MJ2021/PCR-Machine-Construction/Report_3/EE344-EDL REPORT/Images/Schematic2png.png

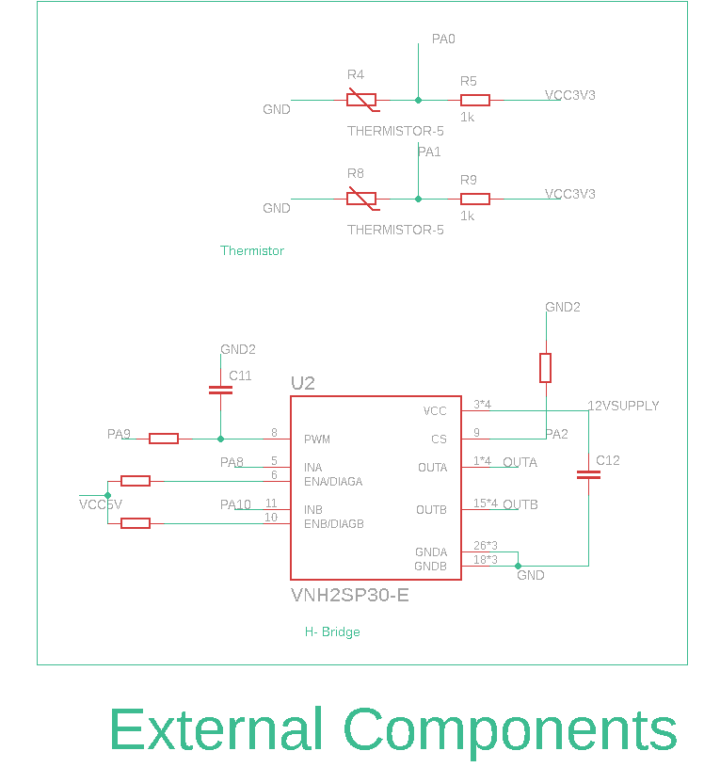
Report_3/EE344-EDL REPORT/Images/Schematic2png.png
