MJ2021/PCR-Machine-Construction/PCR_CAD/Misc/New hinged lid (original).SLDASM

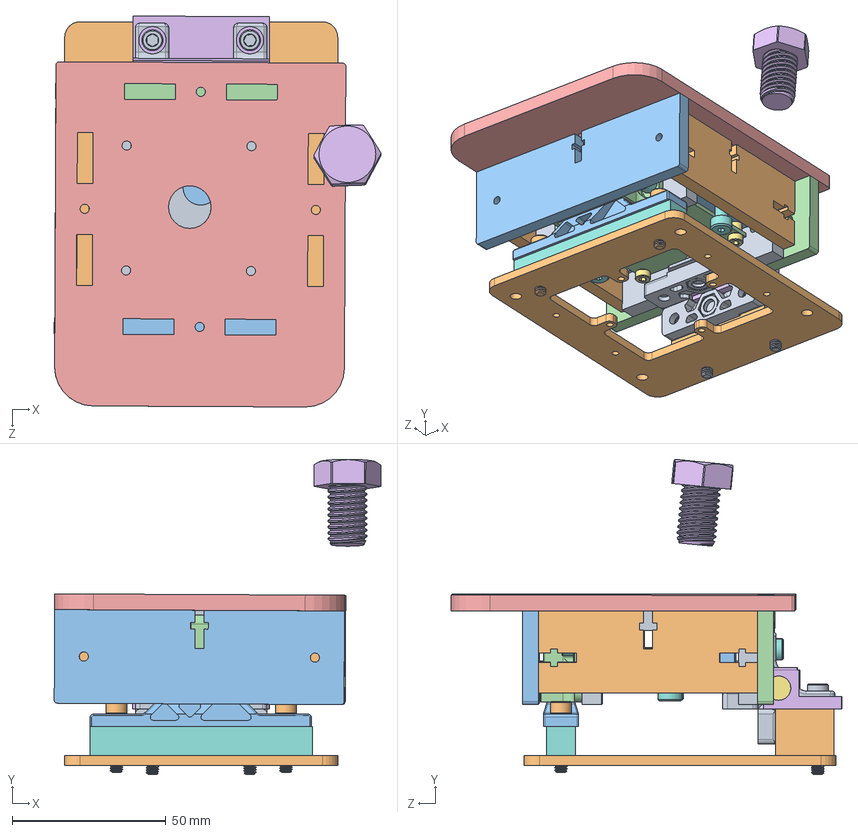
[picture p28: CAD file, 2024-03-14]
PCR_CAD/Misc/New hinged lid (original).SLDASM
106.3 x 102.7 x 127.3 mm
Hinge
Hinge bracket
Heated bracket
Plate
3-4 in bolt
compresed spring 9657K81
1-8 in spacer x 3
Latch bracket
Lid bracket
Mounting plate
SW3dPS-C3-810_c3_keeper_clf
SW3dPS-C3-810_c3_housing_clf
SW3dPS-C3-810_C3_Pawl_Clf
SW3dPS-C3-810_c3_rivet_clf
M3_8mm_SS_screw_91292A112 x 4
3-4in-shoulder screw 3-16 dia x 2
Kapton Heater
Lid_side x 2
Lid_front
Lid_back
Lid_top
Hinge2 x 2
Rod1
5-16in-8-32-hex-screw92196A191 x 6
1in-8-32-hex-92196A199 x 2
3-4in-8-32-hex-92196A197 x 2
