MJ2021/PCR-Machine-Construction/PCR_CAD/Misc/Practice hinge/Hinge1.SLDASM

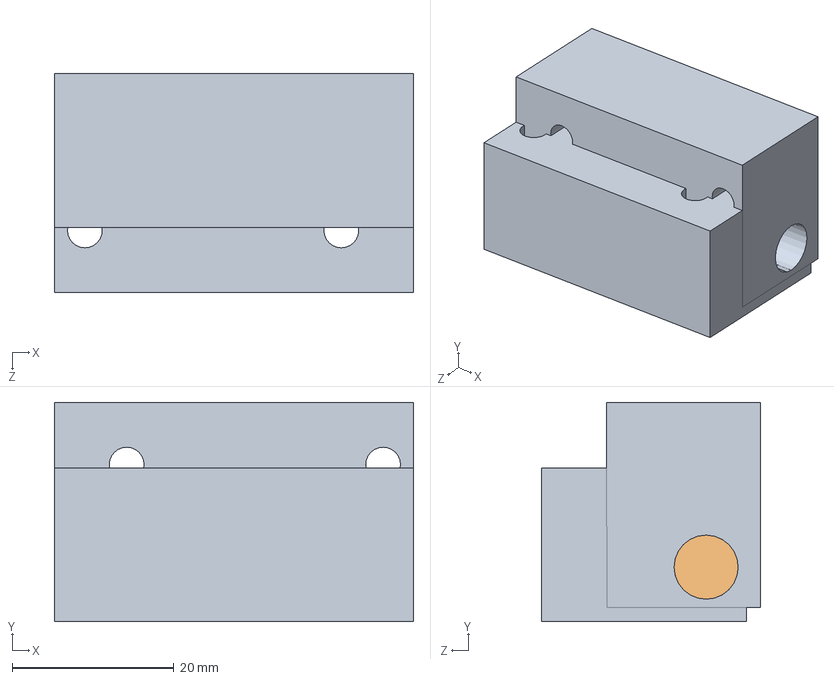
[picture p29: CAD file, 2024-03-14]
PCR_CAD/Misc/Practice hinge/Hinge1.SLDASM
44.5 x 27.1 x 27.1 mm
Hinge2 x 2
Rod1
