MJ2021/PCR-Machine-Construction/PCR_CAD/Heating/Main Heating Block.SLDPRT

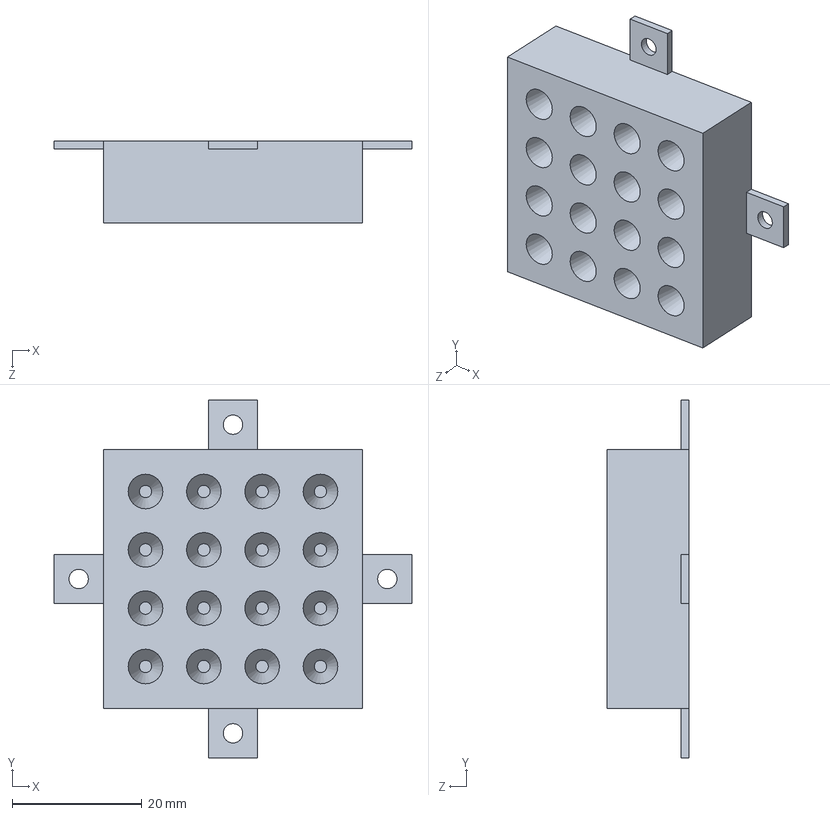
[picture p30: CAD file, 2024-03-14]
PCR_CAD/Heating/Main Heating Block.SLDPRT
55.2 x 55.2 x 12.7 mm
