MJ2021/PCR-Machine-Construction/PCR_CAD/Misc/CK tools prototype A/CK tools prototype.SLDASM

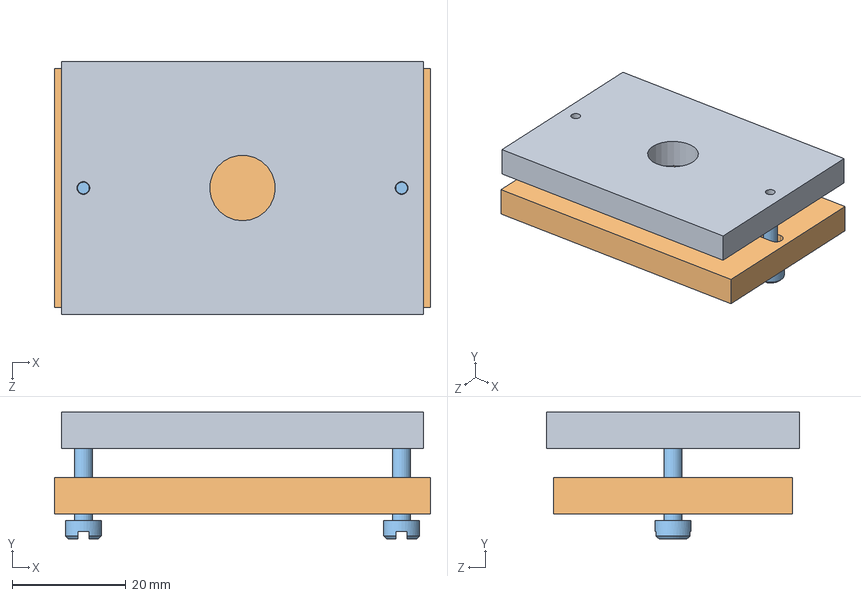
[picture p31: CAD file, 2024-03-14]
PCR_CAD/Misc/CK tools prototype A/CK tools prototype.SLDASM
66.0 x 22.2 x 44.5 mm
Lid Part A
Plate Part B
1-2 in shoulder screw 1-8 dia x 2
