MJ2021/PCR-Machine-Construction/PCR_CAD/Misc/derived_heat_sink_plate.SLDASM

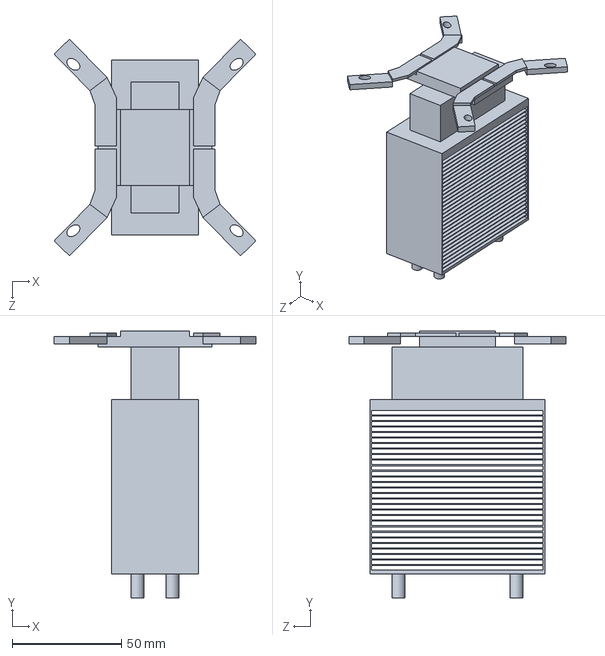
[picture p32: CAD file, 2024-03-14]
PCR_CAD/Misc/derived_heat_sink_plate.SLDASM
92.4 x 122.3 x 99.3 mm
