MJ2021/PCR-Machine-Construction/PCR_CAD/Misc/hinge/hinge_big.SLDASM

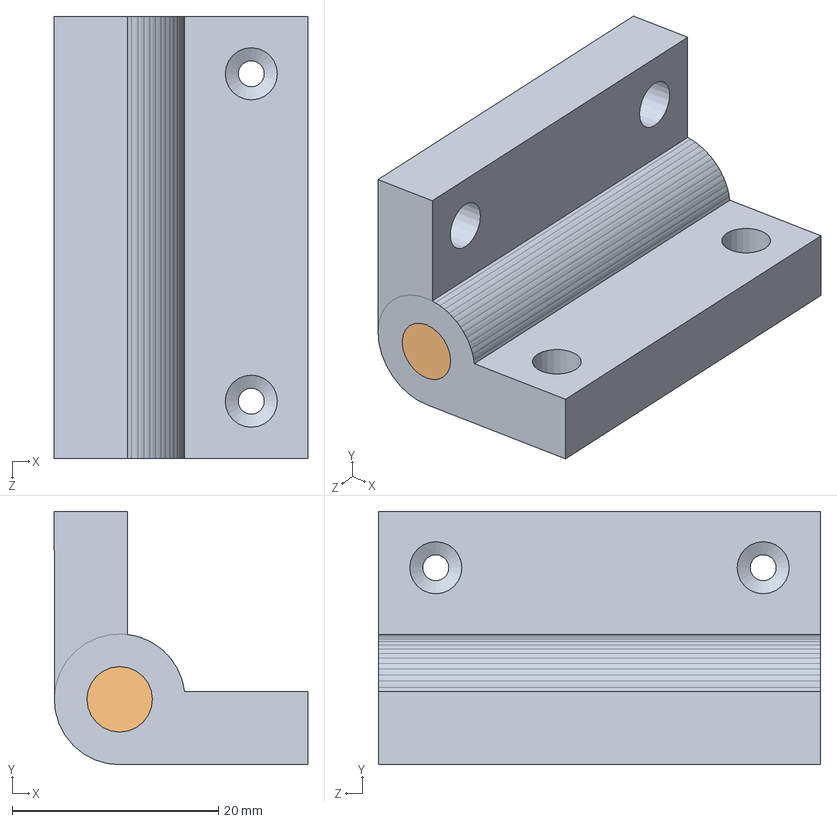
[picture p33: CAD file, 2024-03-14]
PCR_CAD/Misc/hinge/hinge_big.SLDASM
24.6 x 24.6 x 42.9 mm
hinge1 x 2
rod
