MJ2021/PCR-Machine-Construction/PCR_CAD/Misc/SW3dPS-c3-810/SW3dPS-C3-810.sldasm

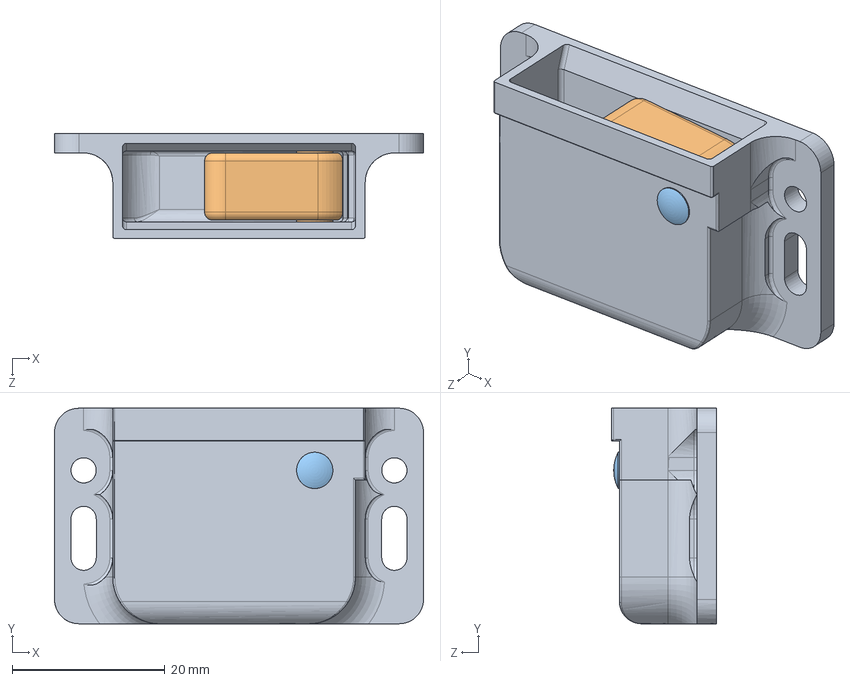
[picture p34: CAD file, 2024-03-14]
PCR_CAD/Misc/SW3dPS-c3-810/SW3dPS-C3-810.sldasm
48.3 x 28.2 x 13.7 mm
SW3dPS-C3-810_c3_housing_clf
SW3dPS-C3-810_C3_Pawl_Clf
SW3dPS-C3-810_c3_rivet_clf
