MJ2021/PCR-Machine-Construction/PCR_CAD/Electronics/Arduino Uno/uno-assy.SLDASM

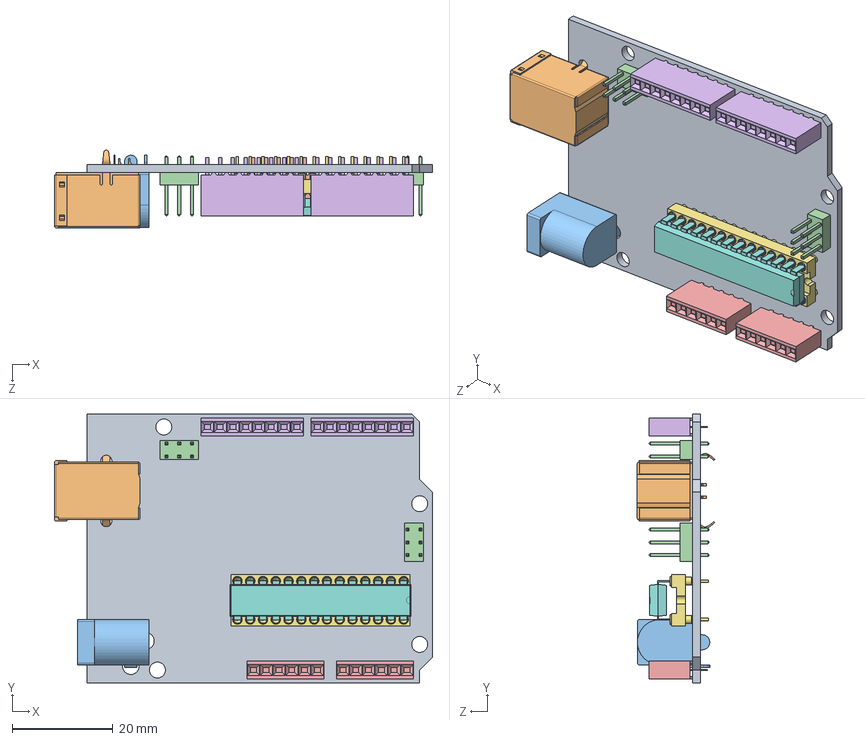
[picture p35: CAD file, 2024-03-14]
PCR_CAD/Electronics/Arduino Uno/uno-assy.SLDASM
75.0 x 53.3 x 15.4 mm
uno-pcb
SW3dPS-67068-0000-molex
RAPC732
3x2-100 x 2
C-0534237-04-3 x 2
C-0534237-06-3 x 2
28pdipskt
User Library-28 pin dip
