MJ2021/PCR-Machine-Construction/PCR_CAD/Misc/deleteme.SLDASM

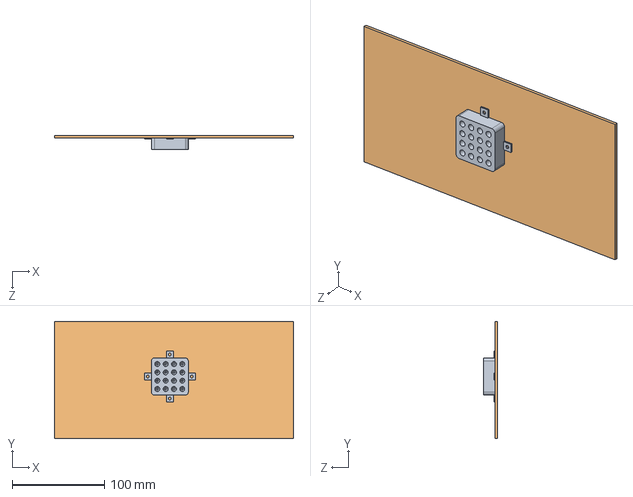
[picture p36: CAD file, 2024-03-14]
PCR_CAD/Misc/deleteme.SLDASM
258.4 x 126.8 x 15.2 mm
Main Heating Block (2)
deleteme
