MJ2021/PCR-Machine-Construction/PCR_CAD/Misc/Open PCR Assem.SLDASM

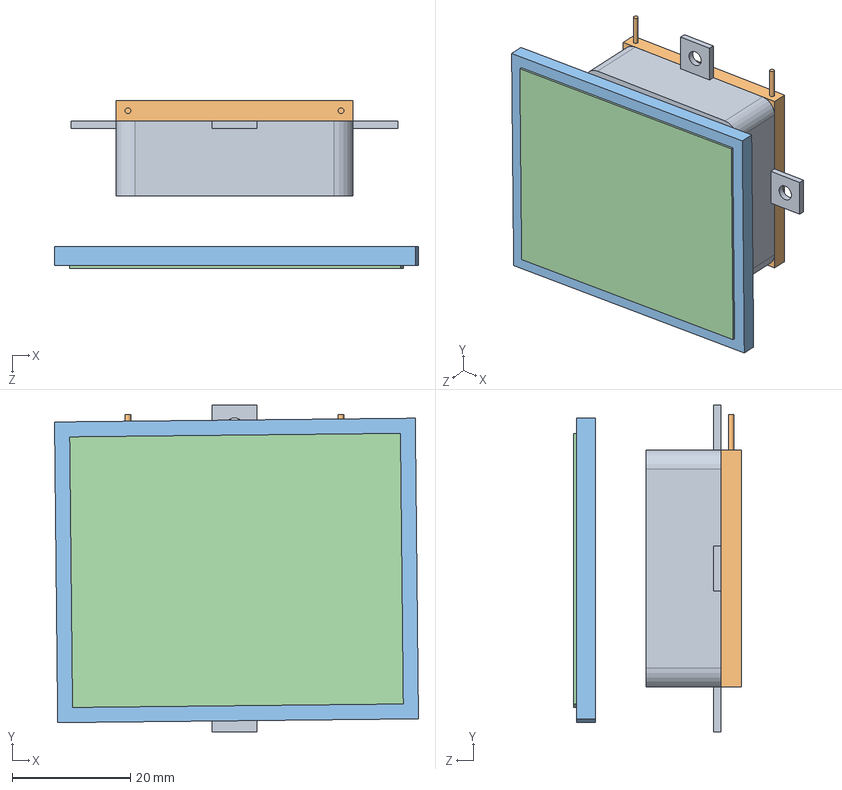
[picture p37: CAD file, 2024-03-14]
PCR_CAD/Misc/Open PCR Assem.SLDASM
61.5 x 55.2 x 28.3 mm
Main Heating Block
VT-127-1.4-1.15-71 Peltier
Top Plate Alum
Kapton Heater
