MJ2021/PCR-Machine-Construction/PCR_CAD/Lid/New hinged lid/New hinged lid.SLDASM

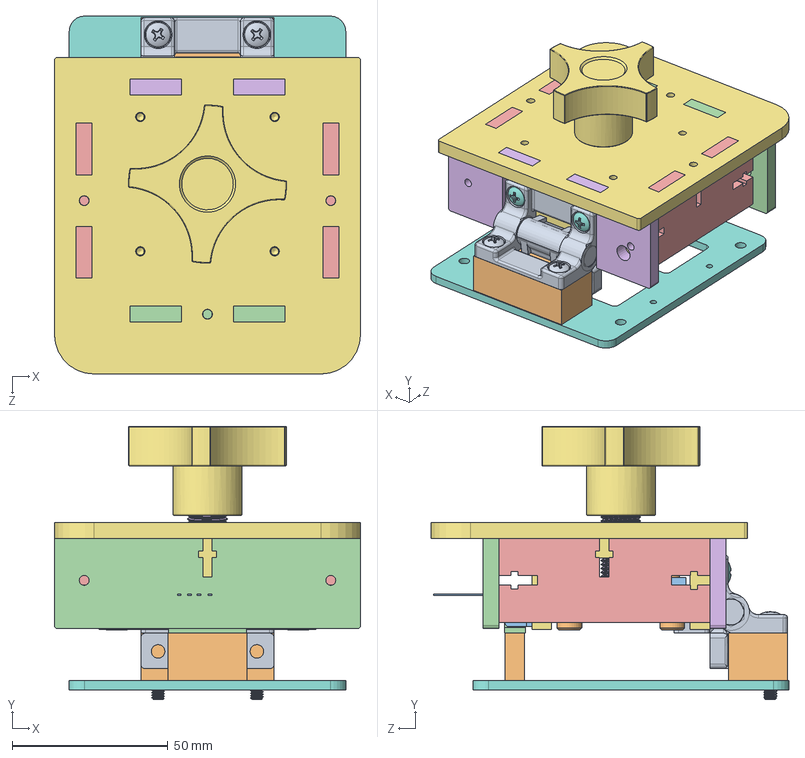
[picture p38: CAD file, 2024-03-14]
PCR_CAD/Lid/New hinged lid/New hinged lid.SLDASM
98.4 x 87.8 x 115.0 mm
Hinge
Hinge bracket
Heated bracket
Plate
compresed spring 9657K81
1-8 in spacer x 3
Lid bracket
Mounting plate
M3_8mm_SS_screw_91292A112 x 4
3-4in-shoulder screw 3-16 dia x 4
Kapton Heater
Lid_front_wood
Lid_side_wood x 2
Lid_back_wood
Lid_top_wood
5-16in-phlps-black-91249A190 x 2
1in-8-32-phlp-91249A201 x 2
latch_bracket_2
latch_2
strike_1
3-4in-6-32-phlp-undercut-91099A224 x 2
1.4inbolt
Bolt with knob
