MJ2021/PCR-Machine-Construction/Part1 (1).SLDPRT

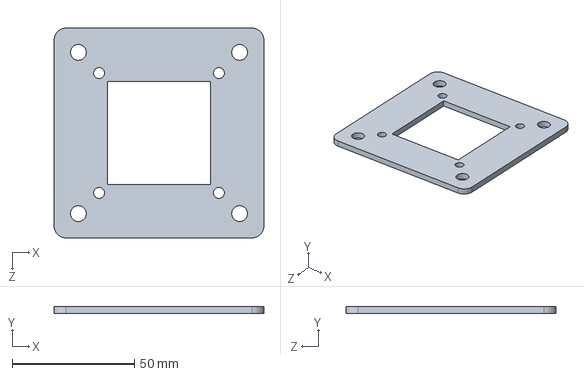
[picture p39: CAD file, 2024-03-14]
Part1 (1).SLDPRT
86.0 x 3.00 x 86.0 mm
