MJ2021/PCR-Machine-Construction/PCR_CAD/Body/Body Front.SLDPRT

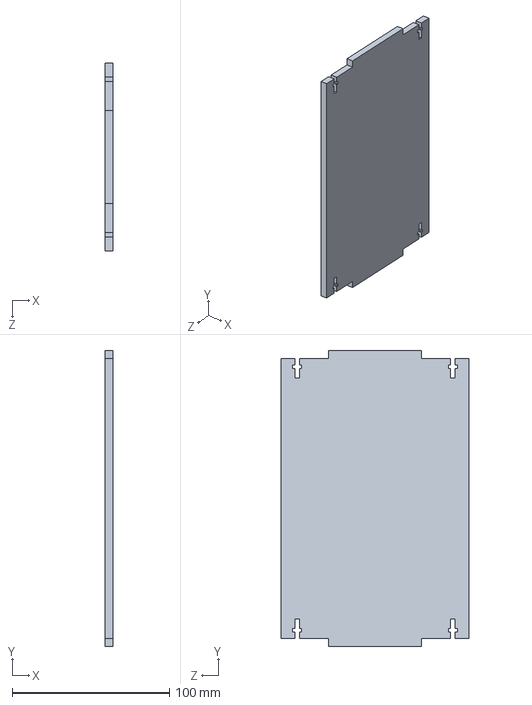
[picture p40: CAD file, 2024-03-14]
PCR_CAD/Body/Body Front.SLDPRT
5.13 x 188.1 x 119.5 mm
