MJ2021/PCR-Machine-Construction/PCR_CAD/Construction/7-16-unthreaded-spacer-94639A712.SLDPRT

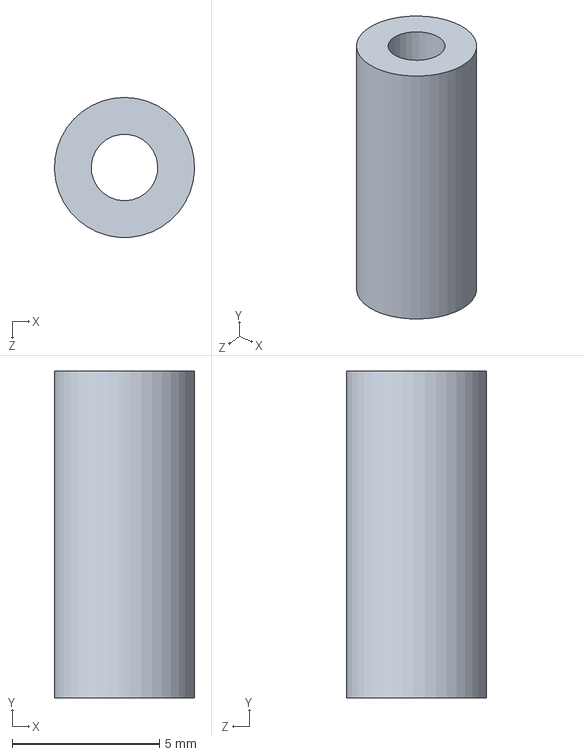
[picture p41: CAD file, 2024-03-14]
PCR_CAD/Construction/7-16-unthreaded-spacer-94639A712.SLDPRT
4.76 x 11.1 x 4.76 mm
