MJ2021/PCR-Machine-Construction/PCR_CAD/Electronics/Arduino Uno/3x2-100.SLDPRT

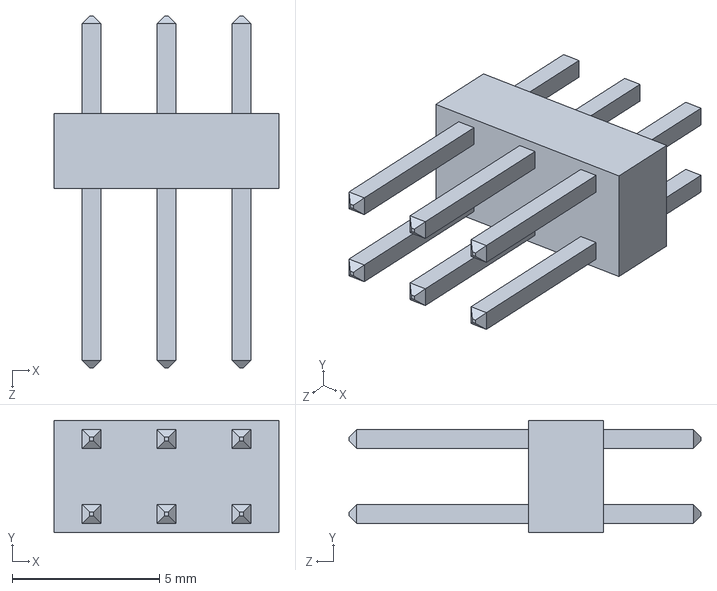
[picture p42: CAD file, 2024-03-14]
PCR_CAD/Electronics/Arduino Uno/3x2-100.SLDPRT
7.62 x 3.81 x 11.9 mm
