MJ2021/PCR-Machine-Construction/PCR_CAD/Electronics/LCD.SLDPRT

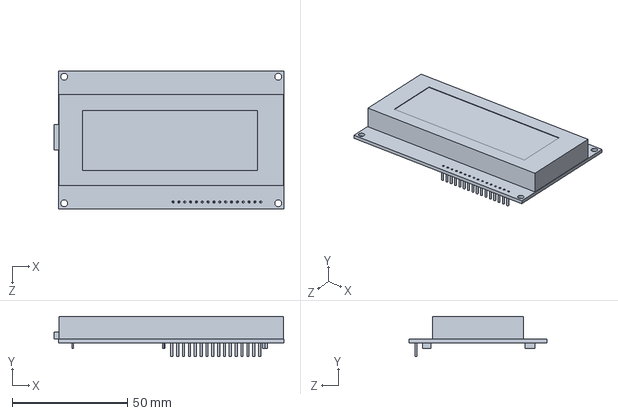
[picture p43: CAD file, 2024-03-14]
PCR_CAD/Electronics/LCD.SLDPRT
99.9 x 17.5 x 60.0 mm
