MJ2021/PCR-Machine-Construction/PCR_CAD/Lid/latch/strike_1.SLDPRT

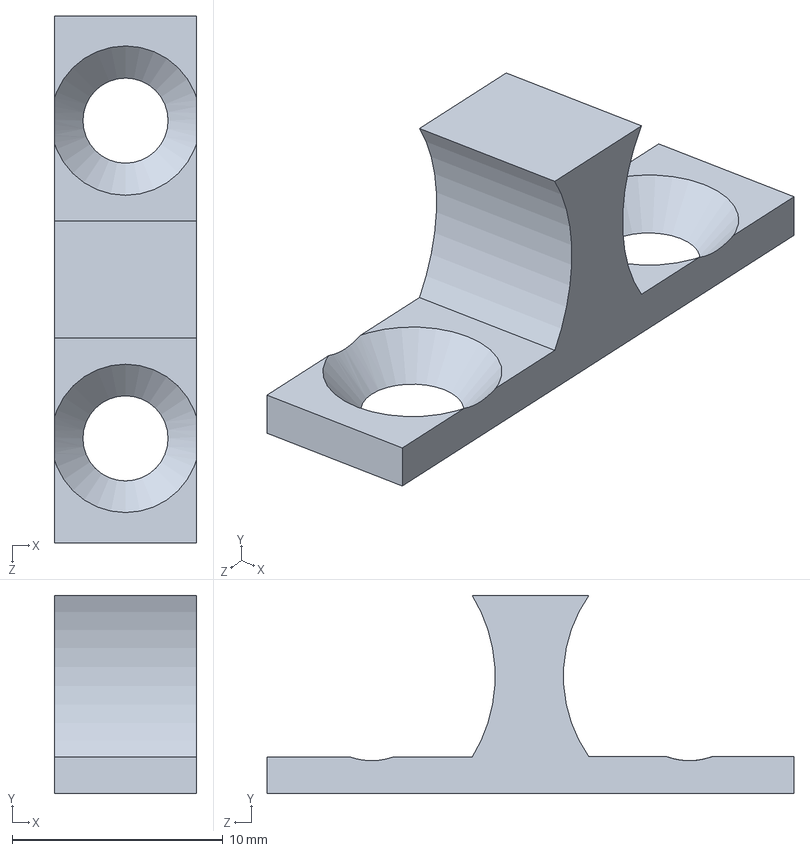
[picture p44: CAD file, 2024-03-14]
PCR_CAD/Lid/latch/strike_1.SLDPRT
6.75 x 9.40 x 25.0 mm
