MJ2021/PCR-Machine-Construction/PCR_CAD/Misc/hinge/rod.SLDPRT

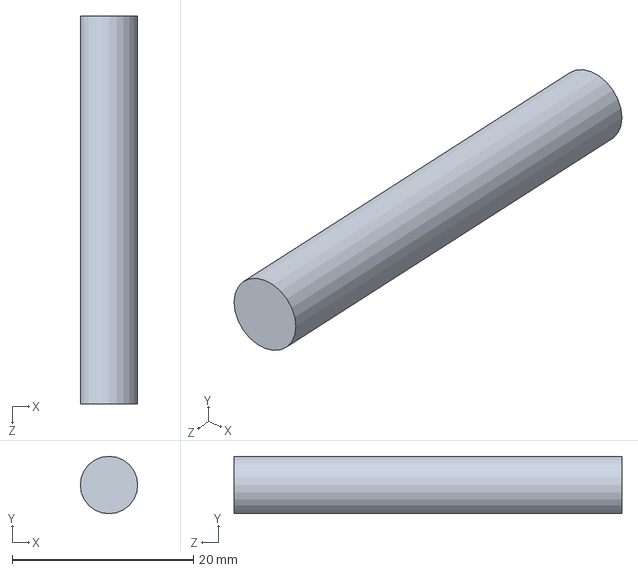
[picture p46: CAD file, 2024-03-14]
PCR_CAD/Misc/hinge/rod.SLDPRT
6.35 x 6.35 x 42.9 mm
