MJ2021/PCR-Machine-Construction/Part3 (1).SLDPRT

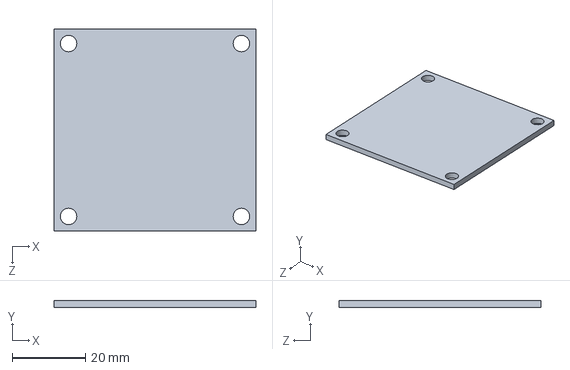
[picture p47: CAD file, 2024-03-14]
Part3 (1).SLDPRT
55.0 x 2.00 x 55.0 mm
