MJ2021/PCR-Machine-Construction/PCR_CAD/Body/Body Side with ports.SLDPRT

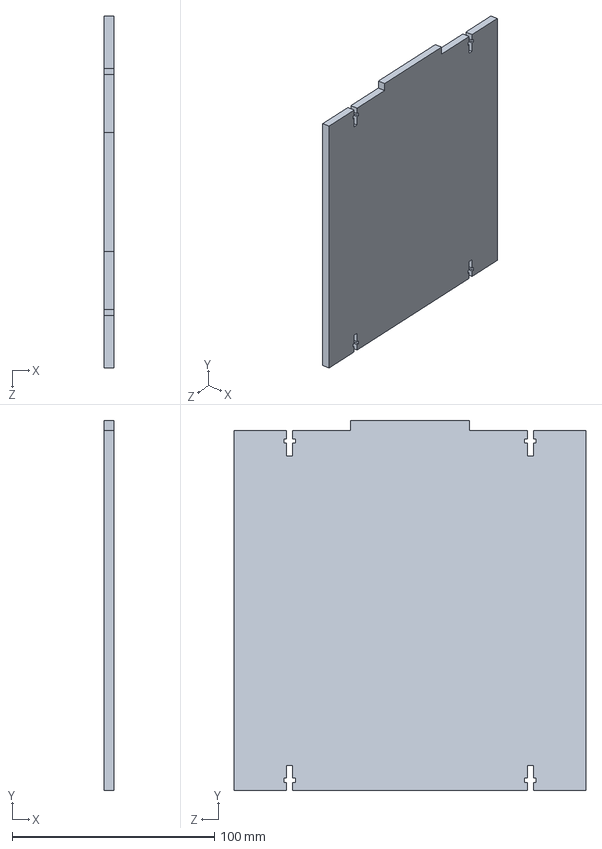
[picture p48: CAD file, 2024-03-14]
PCR_CAD/Body/Body Side with ports.SLDPRT
5.13 x 182.9 x 173.9 mm
