MJ2021/PCR-Machine-Construction/PCR_CAD/Construction/3-16-undercut-91771A143.SLDPRT

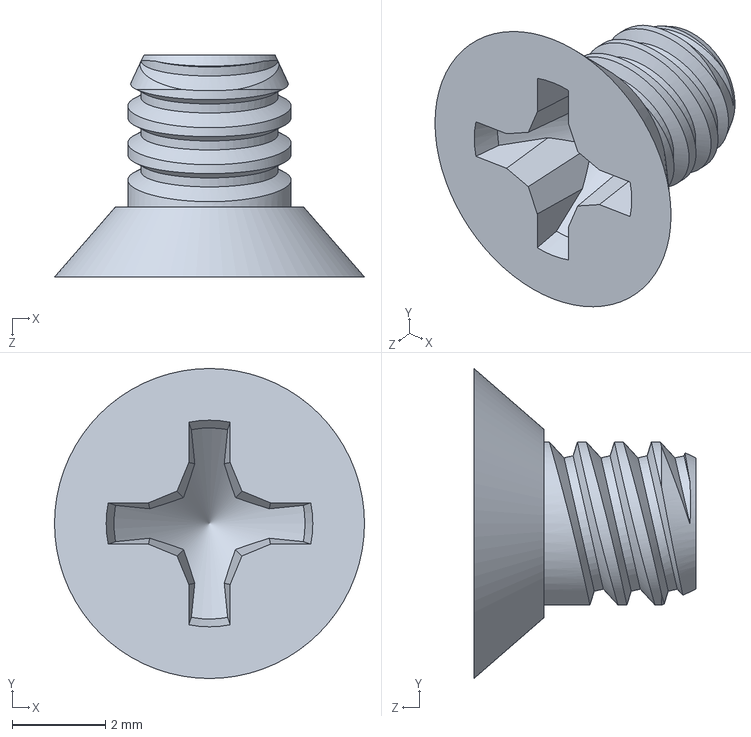
[picture p49: CAD file, 2024-03-14]
PCR_CAD/Construction/3-16-undercut-91771A143.SLDPRT
6.65 x 6.65 x 4.76 mm
