MJ2021/PCR-Machine-Construction/PCR_CAD/Electronics/Arduino Uno/28pdipskt.SLDPRT

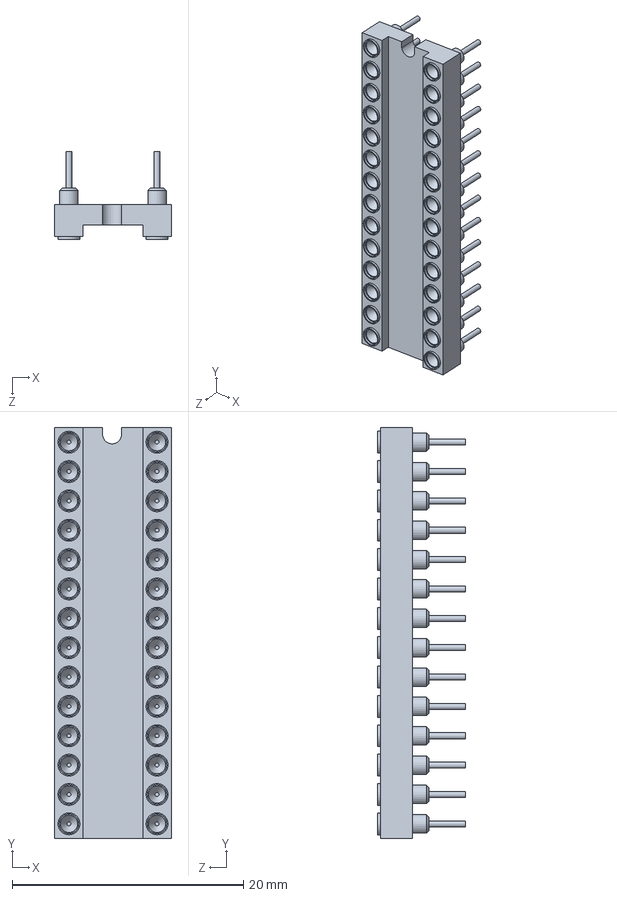
[picture p50: CAD file, 2024-03-14]
PCR_CAD/Electronics/Arduino Uno/28pdipskt.SLDPRT
10.2 x 35.6 x 7.62 mm
