MJ2021/PCR-Machine-Construction/PCR_CAD/Electronics/OpenPCR Circuit board.SLDPRT

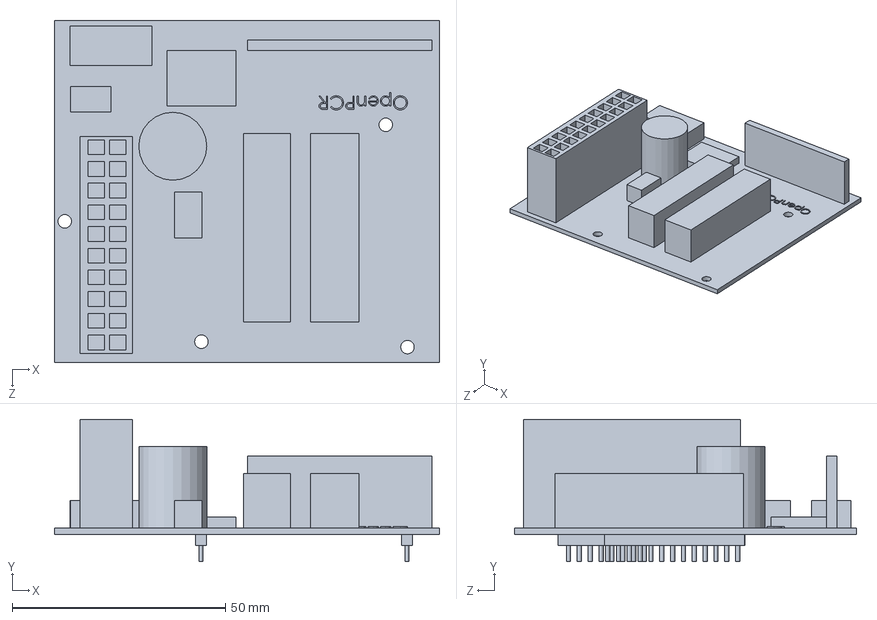
[picture p51: CAD file, 2024-03-14]
PCR_CAD/Electronics/OpenPCR Circuit board.SLDPRT
90.2 x 33.4 x 80.0 mm
