MJ2021/PCR-Machine-Construction/PCR_CAD/Lid/latch/latch_2.SLDPRT

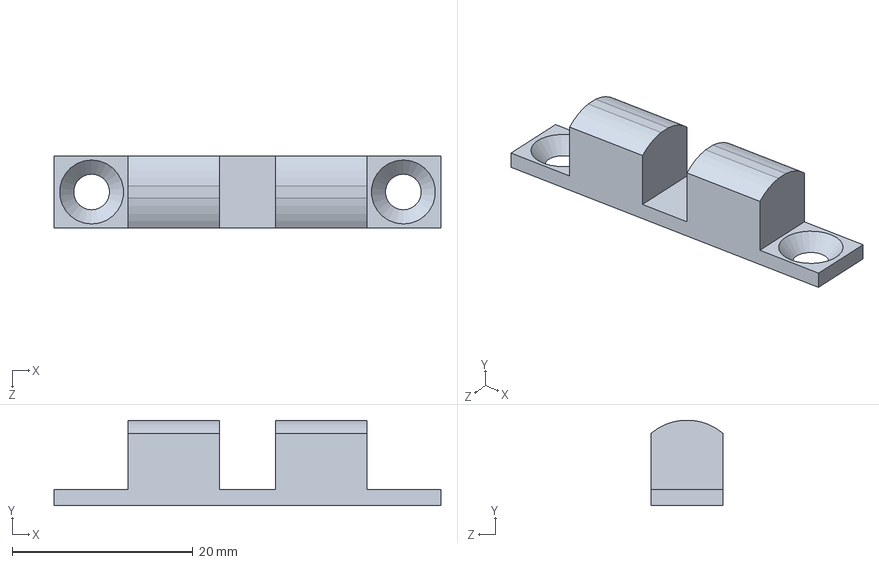
[picture p52: CAD file, 2024-03-14]
PCR_CAD/Lid/latch/latch_2.SLDPRT
42.9 x 9.42 x 7.94 mm
