MJ2021/PCR-Machine-Construction/PCR_CAD/Lid/New hinged lid/Laser cut parts/Lid_side_wood.SLDPRT

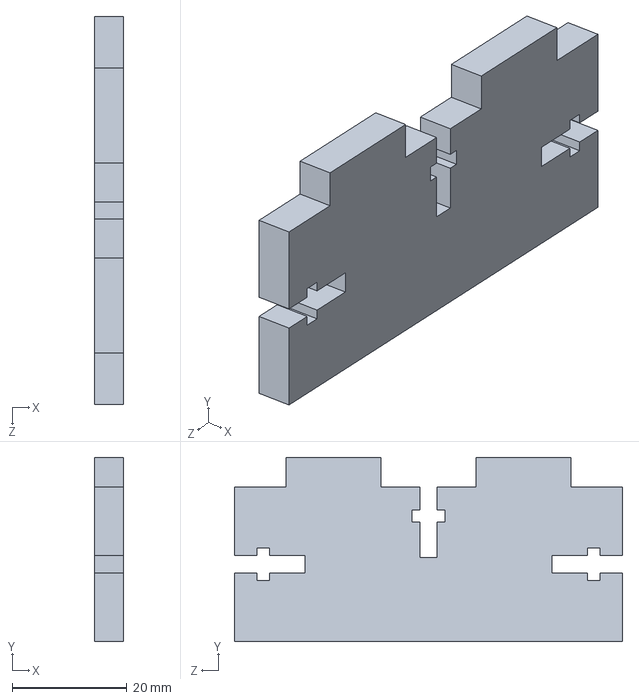
[picture p53: CAD file, 2024-03-14]
PCR_CAD/Lid/New hinged lid/Laser cut parts/Lid_side_wood.SLDPRT
5.13 x 32.1 x 67.8 mm
