MJ2021/PCR-Machine-Construction/PCR_CAD/Lid/New hinged lid/Lid bracket.SLDPRT

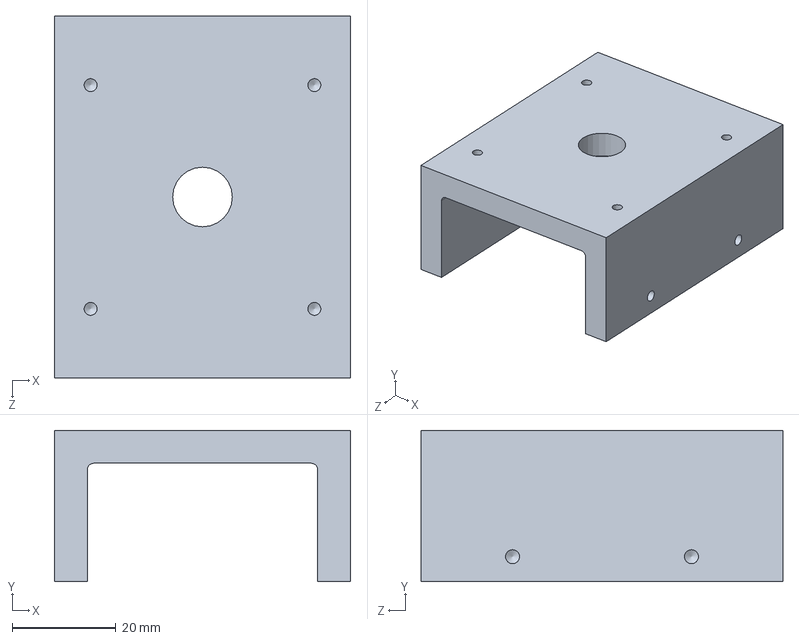
[picture p54: CAD file, 2024-03-14]
PCR_CAD/Lid/New hinged lid/Lid bracket.SLDPRT
57.1 x 29.2 x 69.8 mm
