MJ2021/PCR-Machine-Construction/PCR_CAD/Misc/hinge/hinge1.SLDPRT

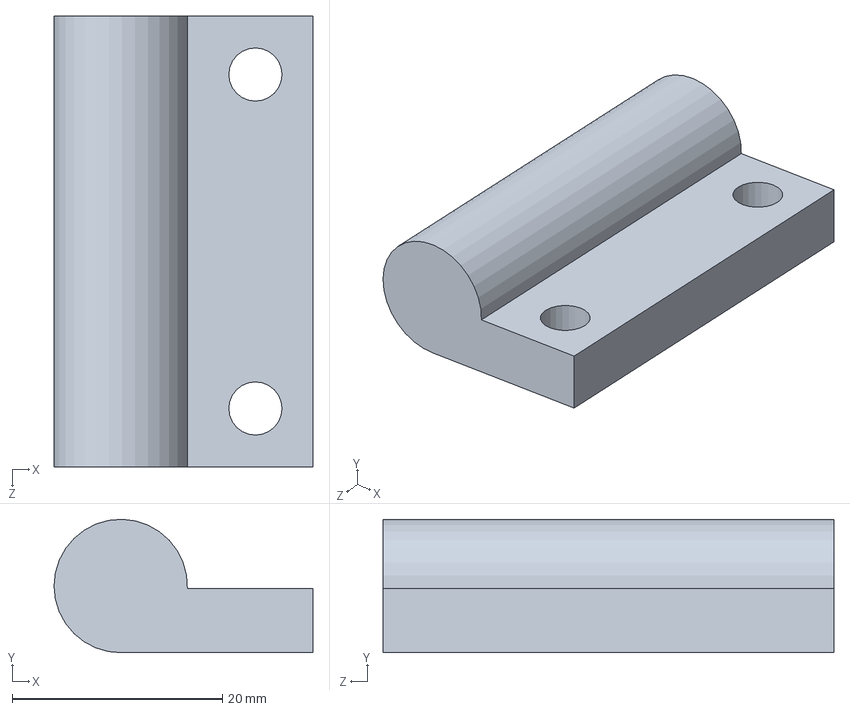
[picture p55: CAD file, 2024-03-14]
PCR_CAD/Misc/hinge/hinge1.SLDPRT
24.6 x 12.7 x 42.9 mm
