MJ2021/PCR-Machine-Construction/PCR_CAD/Misc/Practice hinge/Rod1.SLDPRT

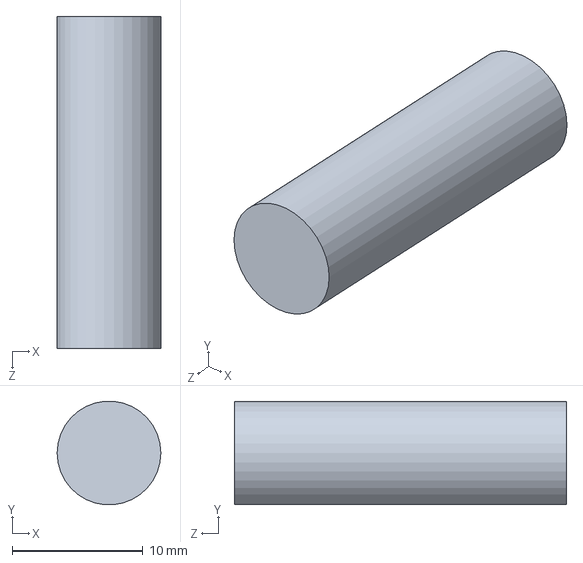
[picture p56: CAD file, 2024-03-14]
PCR_CAD/Misc/Practice hinge/Rod1.SLDPRT
7.94 x 7.90 x 25.4 mm
