MJ2021/PCR-Machine-Construction/Part2 (1).SLDPRT

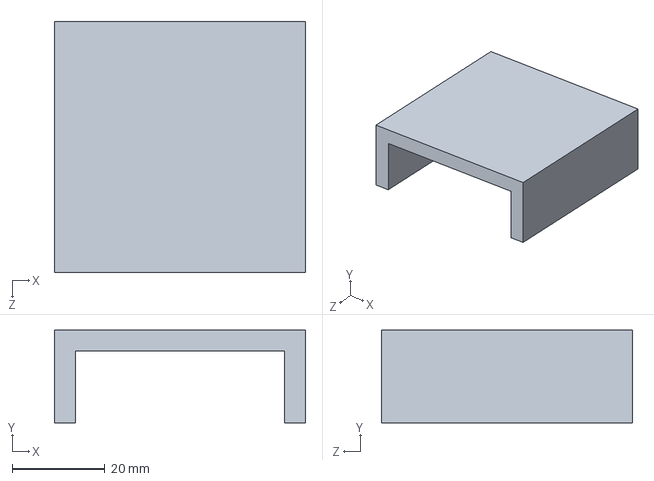
[picture p57: CAD file, 2024-03-14]
Part2 (1).SLDPRT
54.0 x 20.0 x 54.0 mm
