MJ2021/PCR-Machine-Construction/PCR_CAD/Construction/3-4in-8-32-hex-92196A197.SLDPRT

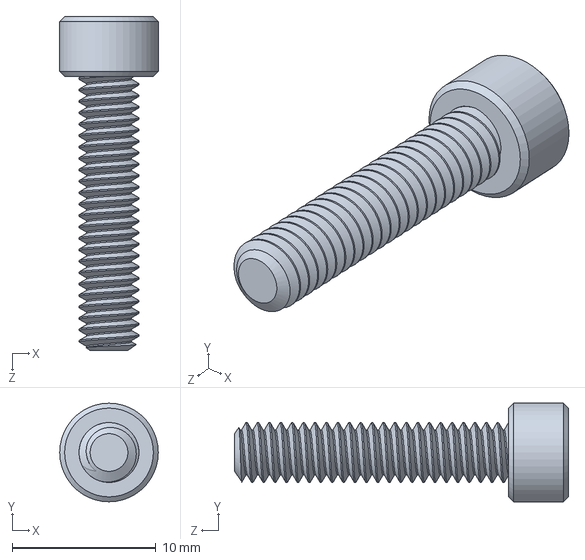
[picture p59: CAD file, 2024-03-14]
PCR_CAD/Construction/3-4in-8-32-hex-92196A197.SLDPRT
6.86 x 6.86 x 23.2 mm
