MJ2021/PCR-Machine-Construction/PCR_CAD/Electronics/Arduino Uno/uno-pcb.SLDPRT

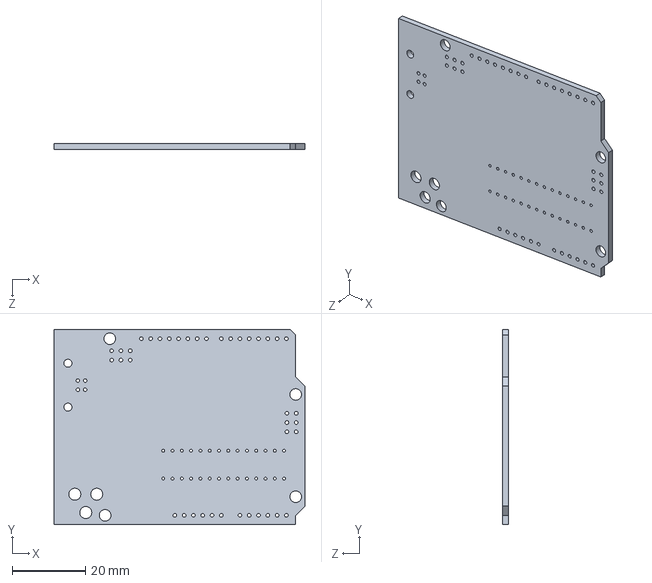
[picture p60: CAD file, 2024-03-14]
PCR_CAD/Electronics/Arduino Uno/uno-pcb.SLDPRT
68.6 x 53.3 x 1.60 mm
