MJ2021/PCR-Machine-Construction/PCR_CAD/Heating/thermal pad 4cm.SLDPRT

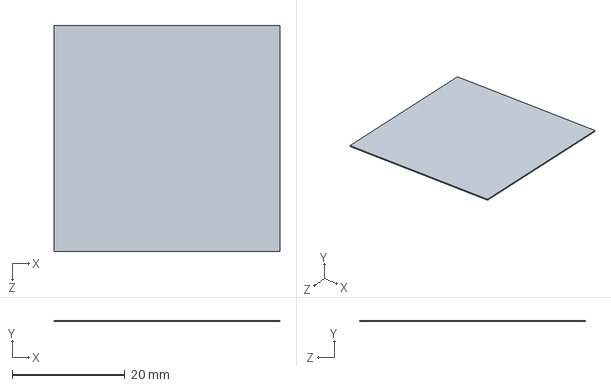
[picture p61: CAD file, 2024-03-14]
PCR_CAD/Heating/thermal pad 4cm.SLDPRT
40.0 x 0.254 x 40.0 mm
