MJ2021/PCR-Machine-Construction/PCR_CAD/Lid/latch/latch_bracket_2.SLDPRT

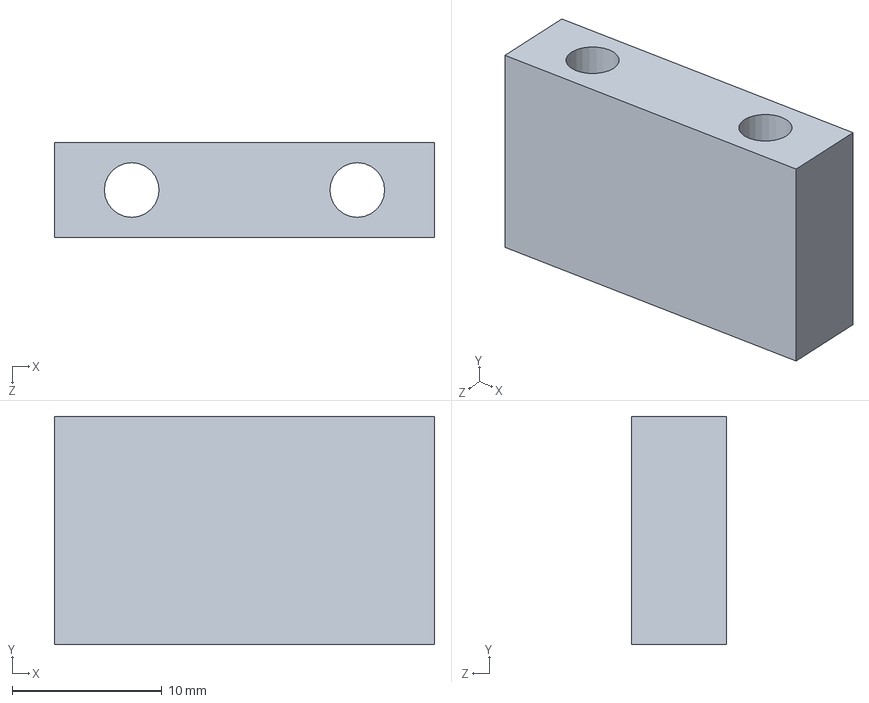
[picture p62: CAD file, 2024-03-14]
PCR_CAD/Lid/latch/latch_bracket_2.SLDPRT
25.4 x 15.2 x 6.35 mm
