MJ2021/PCR-Machine-Construction/PCR_CAD/Lid/New hinged lid/Laser cut parts/Lid_front_wood.SLDPRT

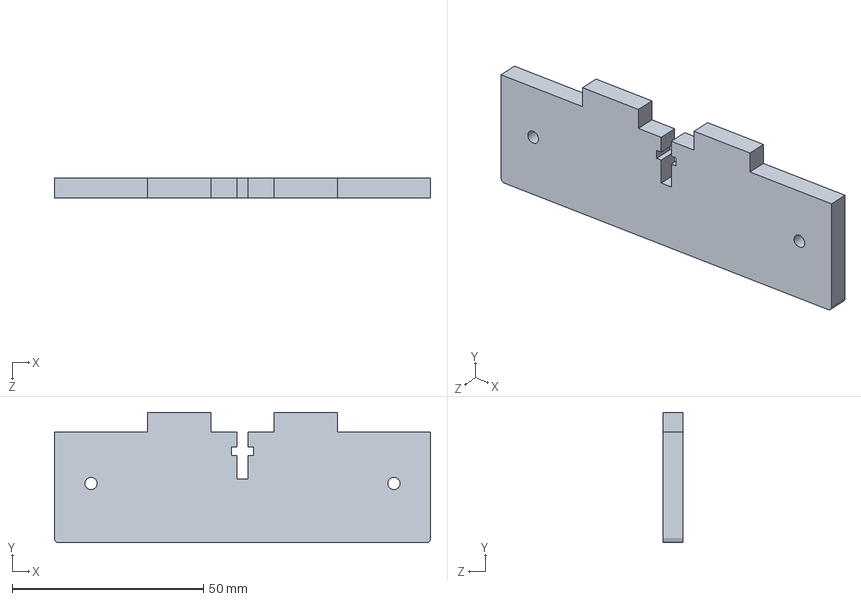
[picture p63: CAD file, 2024-03-14]
PCR_CAD/Lid/New hinged lid/Laser cut parts/Lid_front_wood.SLDPRT
98.4 x 34.1 x 5.13 mm
