MJ2021/PCR-Machine-Construction/PCR_CAD/Misc/CK tools prototype A/Plate Part B.SLDPRT

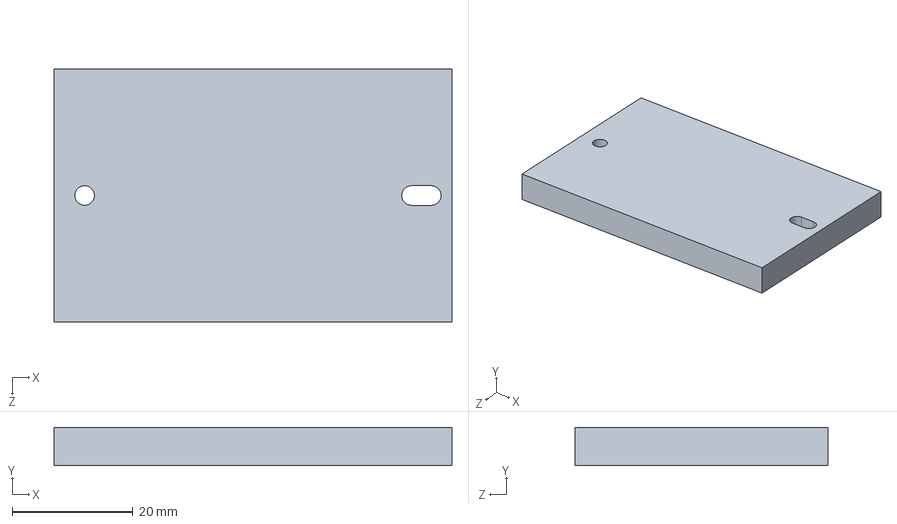
[picture p64: CAD file, 2024-03-14]
PCR_CAD/Misc/CK tools prototype A/Plate Part B.SLDPRT
66.0 x 6.35 x 41.9 mm
