MJ2021/PCR-Machine-Construction/PCR_CAD/Misc/Practice hinge/Hinge2.SLDPRT

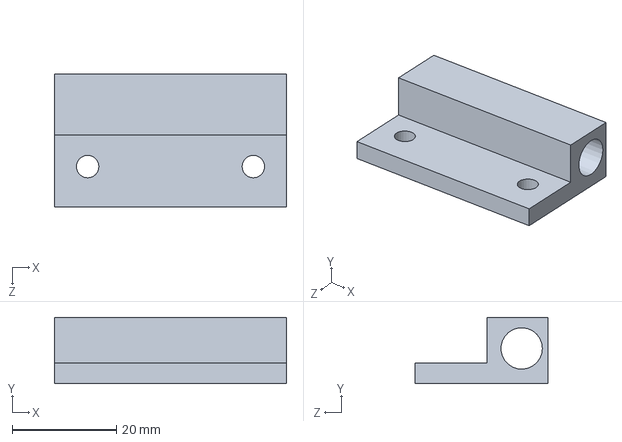
[picture p65: CAD file, 2024-03-14]
PCR_CAD/Misc/Practice hinge/Hinge2.SLDPRT
44.5 x 12.7 x 25.4 mm
