MJ2021/PCR-Machine-Construction/PCR_CAD/Body/Body Top.SLDPRT

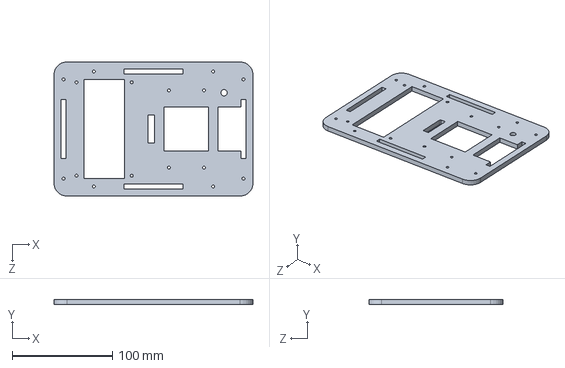
[picture p66: CAD file, 2024-03-14]
PCR_CAD/Body/Body Top.SLDPRT
198.1 x 5.13 x 133.5 mm
