MJ2021/PCR-Machine-Construction/PCR_CAD/Electronics/Arduino Uno/SW3dPS-67068-0000-molex.SLDPRT

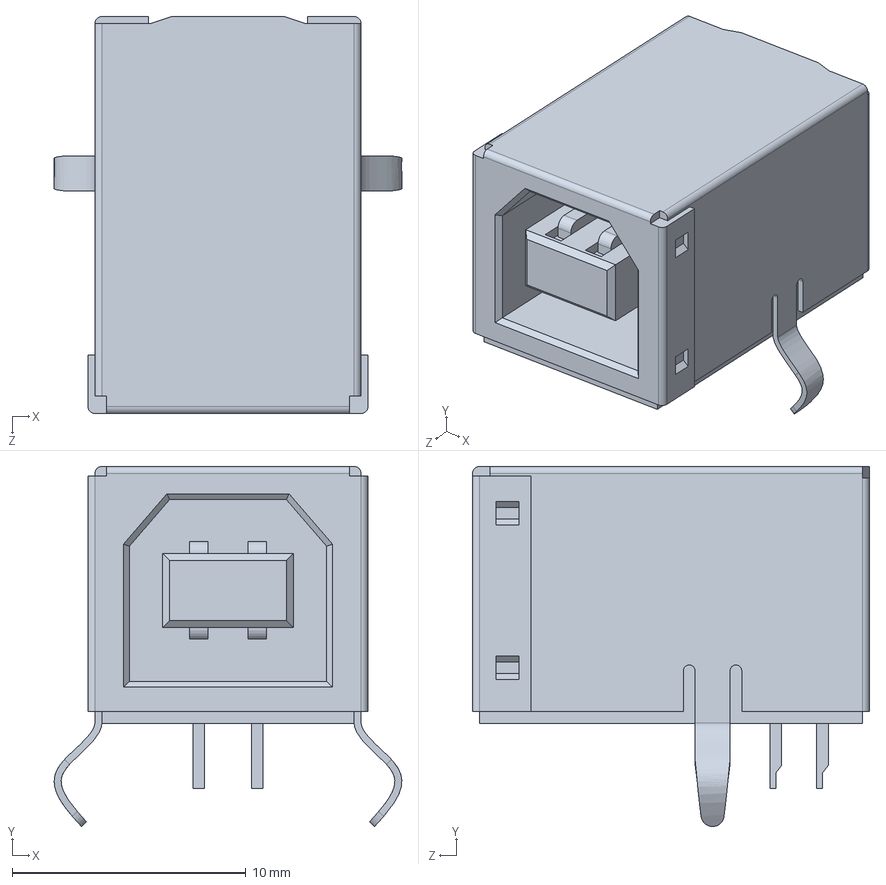
[picture p67: CAD file, 2024-03-14]
PCR_CAD/Electronics/Arduino Uno/SW3dPS-67068-0000-molex.SLDPRT
14.9 x 15.4 x 17.0 mm
