MJ2021/PCR-Machine-Construction/PCR_CAD/Lid/New hinged lid/compresed spring  9657K81.SLDPRT

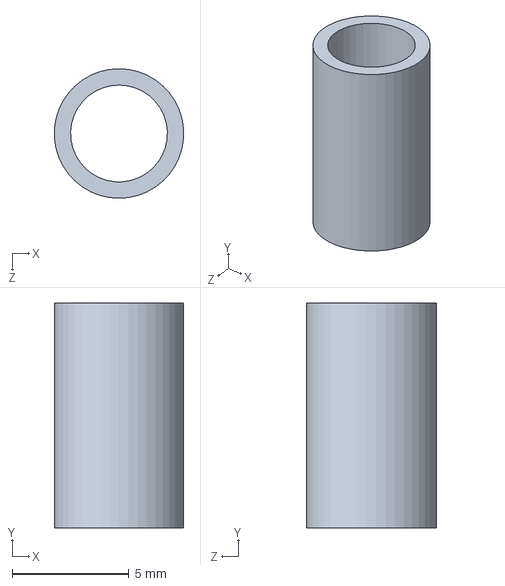
[picture p68: CAD file, 2024-03-14]
PCR_CAD/Lid/New hinged lid/compresed spring 9657K81.SLDPRT
5.54 x 9.65 x 5.56 mm
