MJ2021/PCR-Machine-Construction/PCR_CAD/Lid/New hinged lid/Laser cut parts/Lid_top_wood.SLDPRT

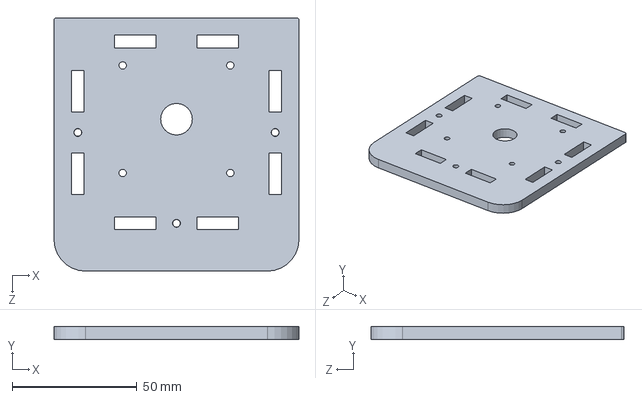
[picture p69: CAD file, 2024-03-14]
PCR_CAD/Lid/New hinged lid/Laser cut parts/Lid_top_wood.SLDPRT
98.4 x 5.13 x 101.7 mm
