MJ2021/PCR-Machine-Construction/PCR_CAD/Misc/CK tools prototype A/Lid Part A.SLDPRT

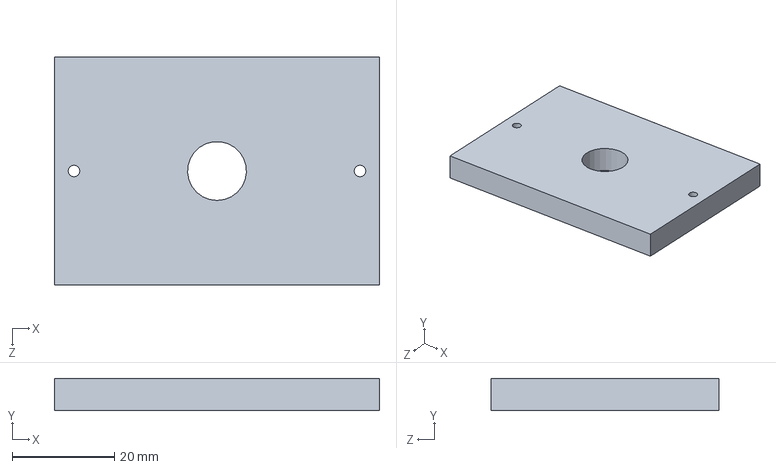
[picture p70: CAD file, 2024-03-14]
PCR_CAD/Misc/CK tools prototype A/Lid Part A.SLDPRT
63.5 x 6.35 x 44.5 mm
