MJ2021/PCR-Machine-Construction/PCR_CAD/Body/Body Back.SLDPRT

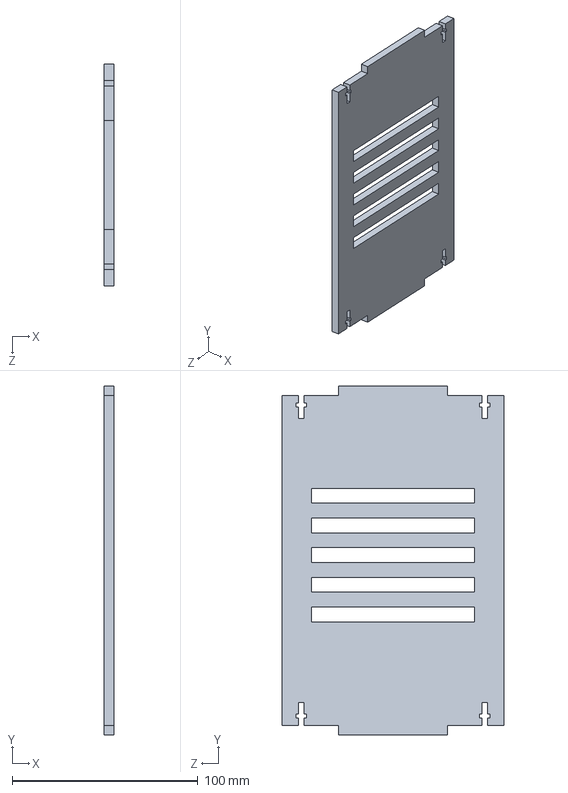
[picture p71: CAD file, 2024-03-14]
PCR_CAD/Body/Body Back.SLDPRT
5.13 x 188.1 x 119.5 mm
