MJ2021/PCR-Machine-Construction/PCR_CAD/Construction/5-16in-8-32-phil-91249A190.SLDPRT

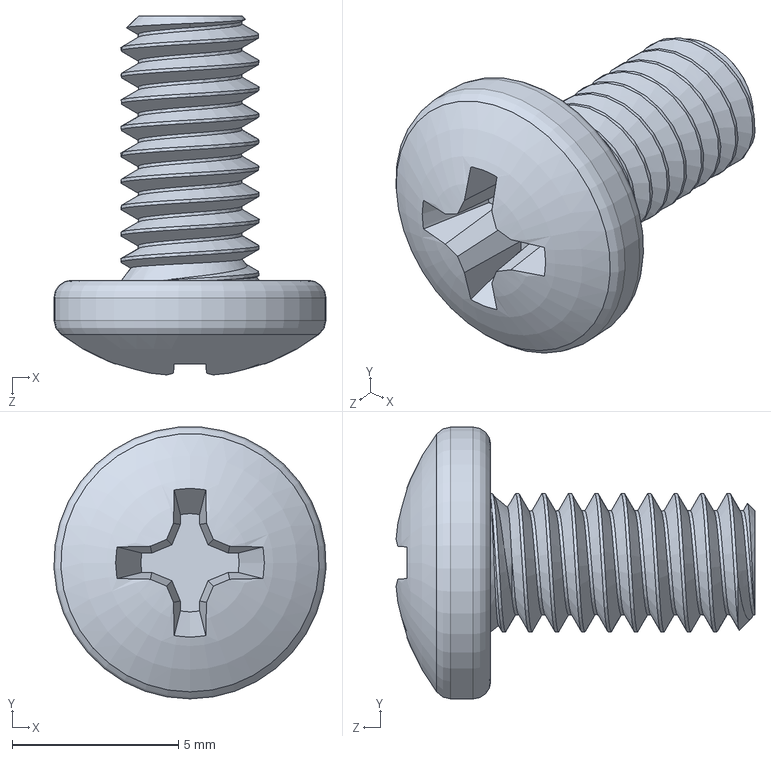
[picture p72: CAD file, 2024-03-14]
PCR_CAD/Construction/5-16in-8-32-phil-91249A190.SLDPRT
8.17 x 8.16 x 10.8 mm
