MJ2021/PCR-Machine-Construction/PCR_CAD/Electronics/Arduino Uno/C-0534237-06-3.SLDPRT

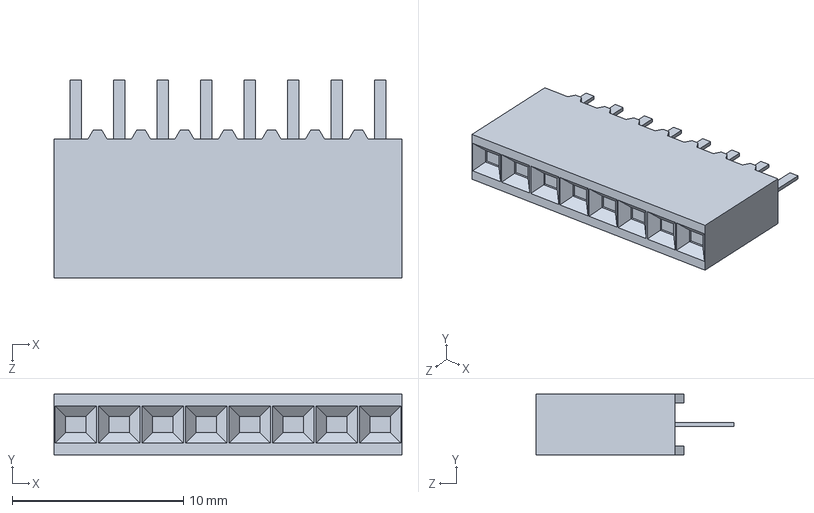
[picture p73: CAD file, 2024-03-14]
PCR_CAD/Electronics/Arduino Uno/C-0534237-06-3.SLDPRT
20.3 x 3.56 x 11.6 mm
