MJ2021/PCR-Machine-Construction/PCR_CAD/Heating/Heated lid plate.SLDPRT

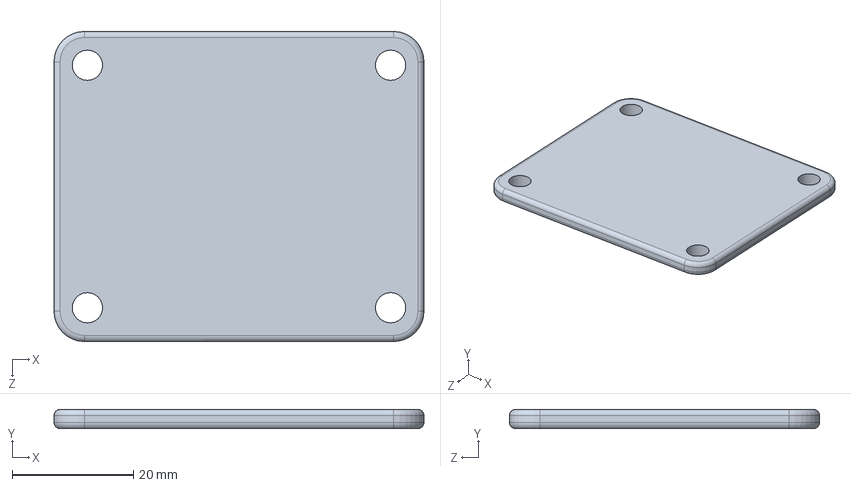
[picture p74: CAD file, 2024-03-14]
PCR_CAD/Heating/Heated lid plate.SLDPRT
61.0 x 3.17 x 51.1 mm
