MJ2021/PCR-Machine-Construction/PCR_CAD/Lid/New hinged lid/Heated bracket.SLDPRT

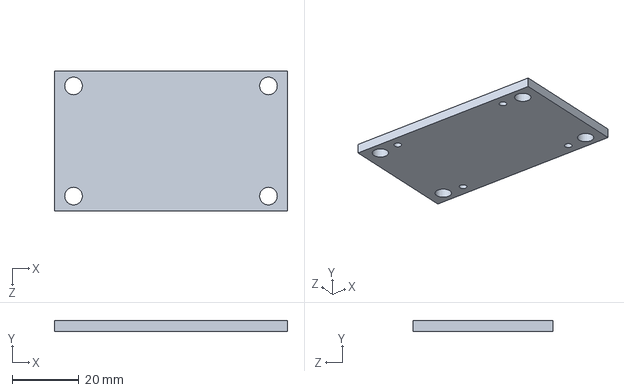
[picture p75: CAD file, 2024-03-14]
PCR_CAD/Lid/New hinged lid/Heated bracket.SLDPRT
69.8 x 3.17 x 41.9 mm
