MJ2021/PCR-Machine-Construction/PCR_CAD/Misc/Lid_back.SLDPRT

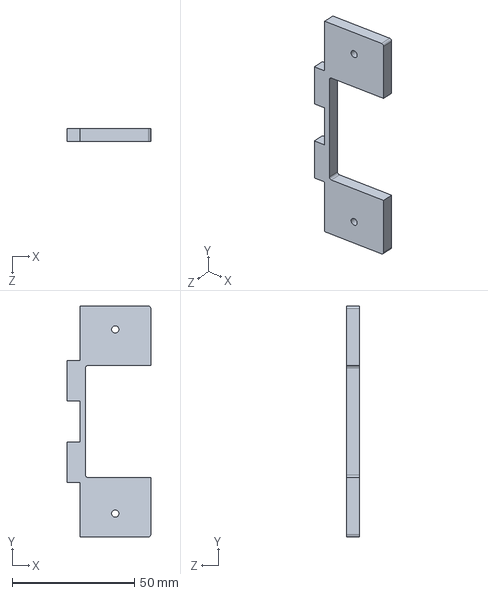
[picture p76: CAD file, 2024-03-14]
PCR_CAD/Misc/Lid_back.SLDPRT
34.1 x 94.4 x 5.13 mm
