MJ2021/PCR-Machine-Construction/PCR_CAD/Body/Body Side.SLDPRT

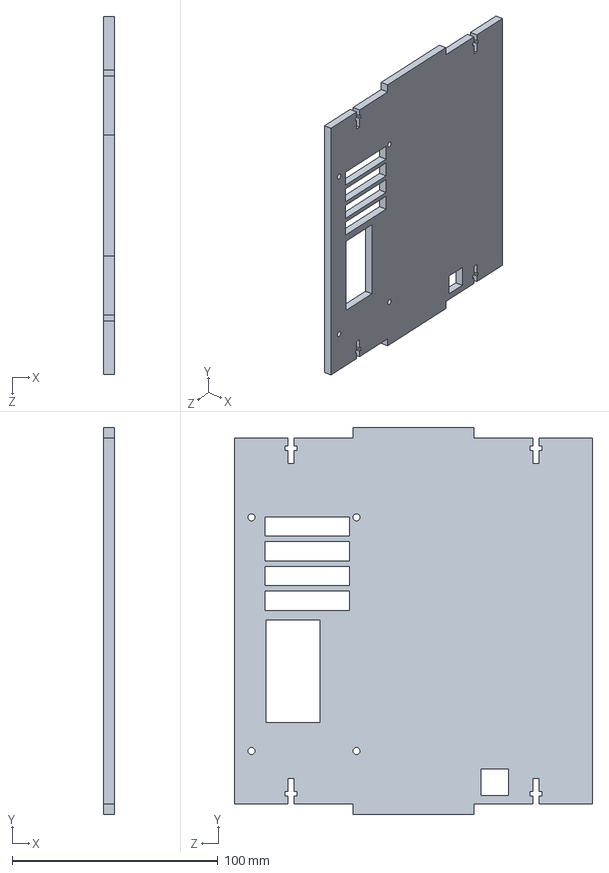
[picture p77: CAD file, 2024-03-14]
PCR_CAD/Body/Body Side.SLDPRT
5.13 x 188.1 x 173.9 mm
