MJ2021/PCR-Machine-Construction/PCR_CAD/Construction/Snap ring.SLDPRT

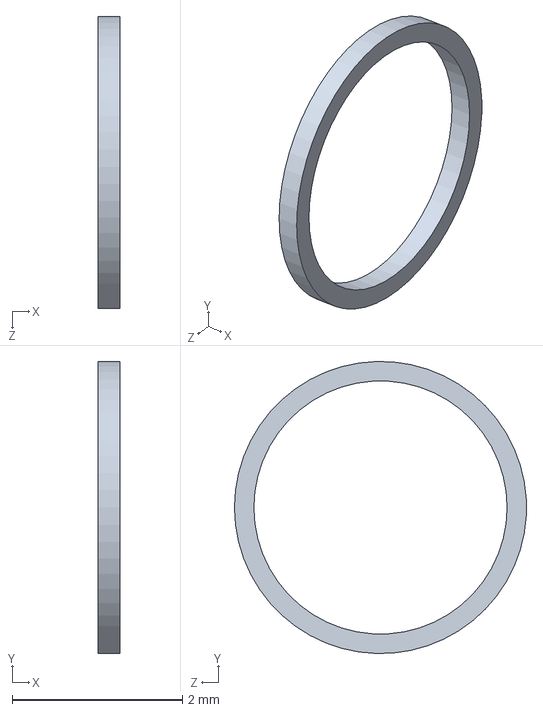
[picture p78: CAD file, 2024-03-14]
PCR_CAD/Construction/Snap ring.SLDPRT
0.254 x 3.43 x 3.43 mm
