MJ2021/PCR-Machine-Construction/PCR_CAD/Electronics/Arduino Uno/C-0534237-04-3.SLDPRT

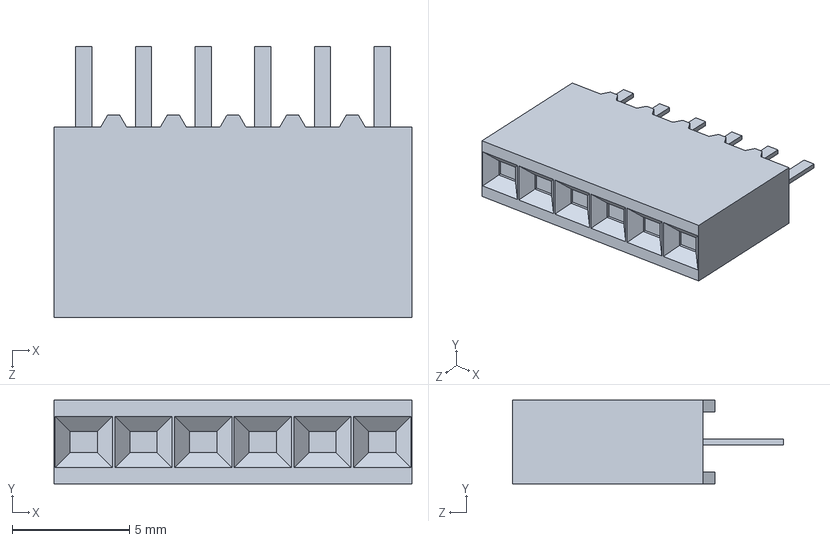
[picture p79: CAD file, 2024-03-14]
PCR_CAD/Electronics/Arduino Uno/C-0534237-04-3.SLDPRT
15.2 x 3.56 x 11.6 mm
