MJ2021/PCR-Machine-Construction/PCR_CAD/Heating/Heat Sink Fan.SLDPRT

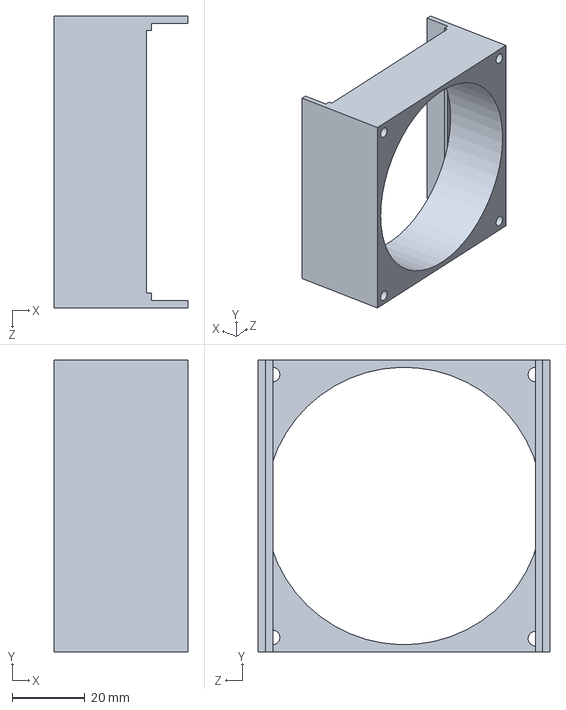
[picture p80: CAD file, 2024-03-14]
PCR_CAD/Heating/Heat Sink Fan.SLDPRT
36.7 x 80.0 x 80.0 mm
