MJ2021/PCR-Machine-Construction/PCR_CAD/Construction/5mm_spacer_93657A073.SLDPRT

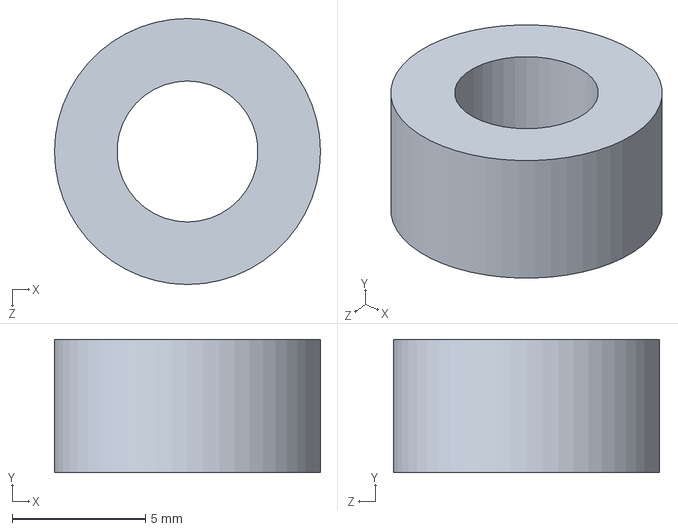
[picture p81: CAD file, 2024-03-14]
PCR_CAD/Construction/5mm_spacer_93657A073.SLDPRT
10.0 x 5.00 x 10.0 mm
