MJ2021/PCR-Machine-Construction/PCR_CAD/Electronics/Arduino Uno/User Library-28 pin dip.SLDPRT

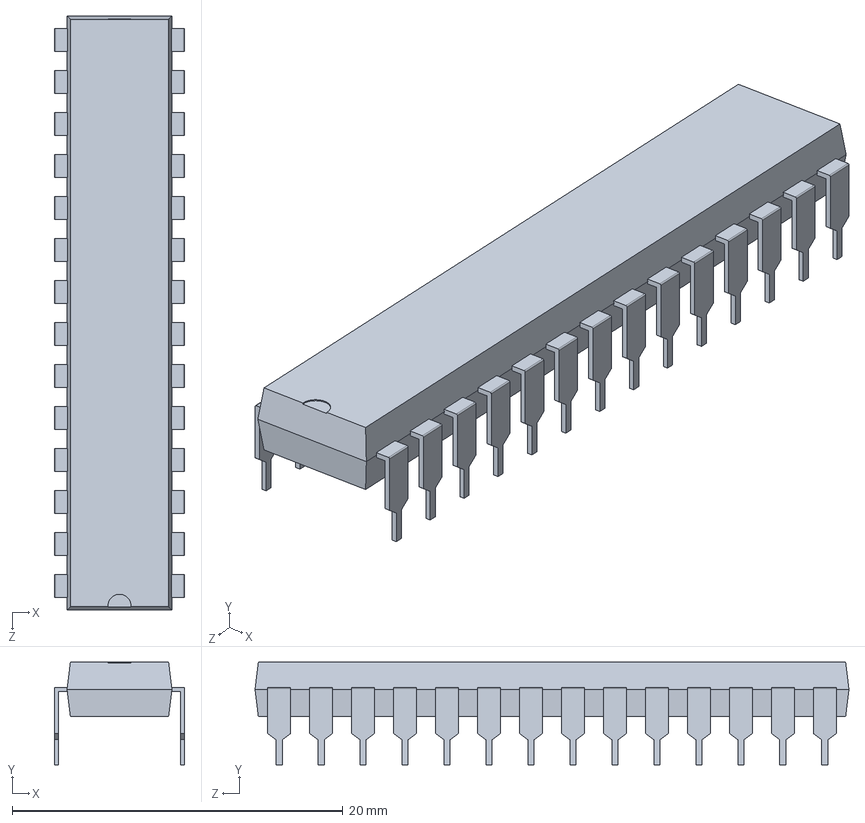
[picture p82: CAD file, 2024-03-14]
PCR_CAD/Electronics/Arduino Uno/User Library-28 pin dip.SLDPRT
7.87 x 6.22 x 35.9 mm
