MJ2021/PCR-Machine-Construction/PCR_CAD/Heating/VT-127-1.4-1.15-71 Peltier.SLDPRT

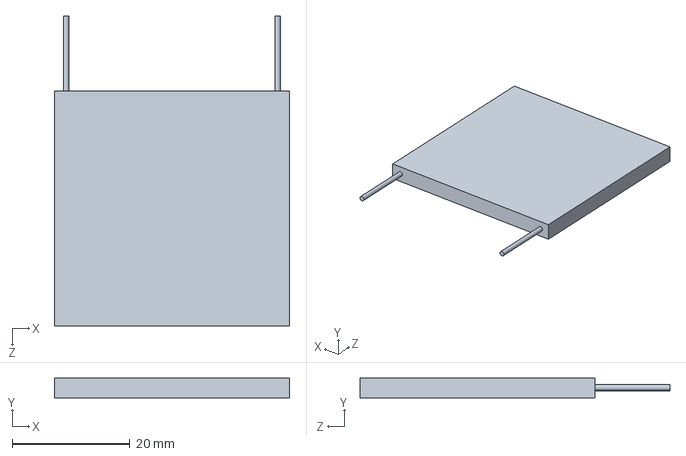
[picture p83: CAD file, 2024-03-14]
PCR_CAD/Heating/VT-127-1.4-1.15-71 Peltier.SLDPRT
40.0 x 3.40 x 52.7 mm
