MJ2021/PCR-Machine-Construction/PCR_CAD/Lid/New hinged lid/Rubber tubing.SLDPRT

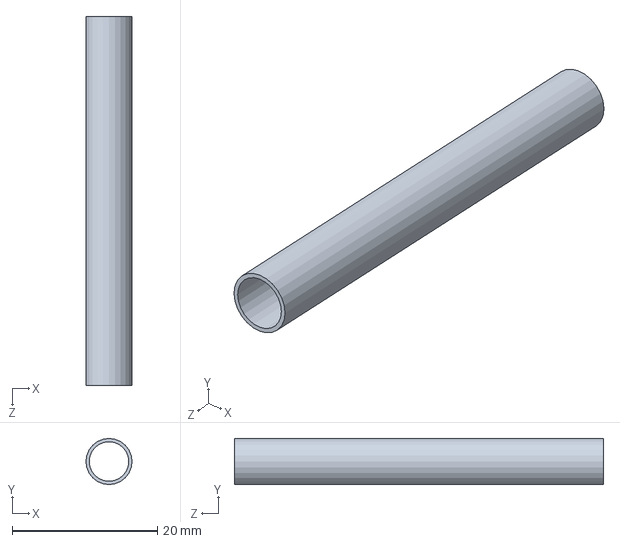
[picture p84: CAD file, 2024-03-14]
PCR_CAD/Lid/New hinged lid/Rubber tubing.SLDPRT
6.35 x 6.35 x 50.8 mm
