MJ2021/PCR-Machine-Construction/PCR_CAD/Misc/Fan.SLDPRT

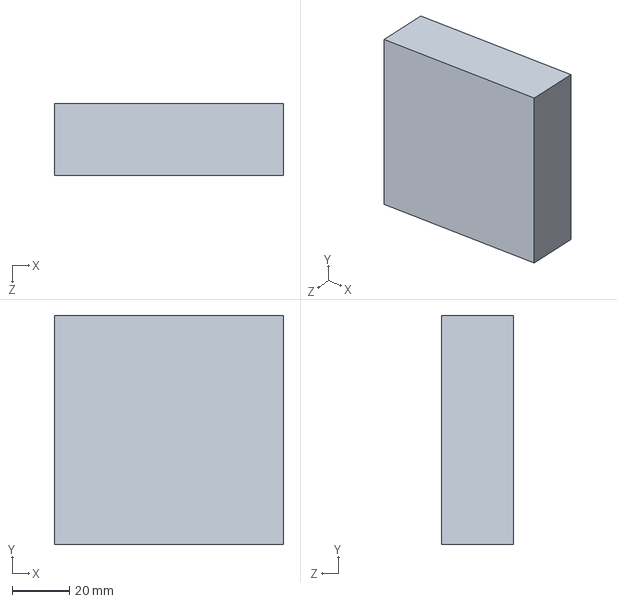
[picture p85: CAD file, 2024-03-14]
PCR_CAD/Misc/Fan.SLDPRT
80.0 x 80.0 x 25.0 mm
