MJ2021/PCR-Machine-Construction/PCR_CAD/Electronics/Arduino Uno/RAPC732.sldprt

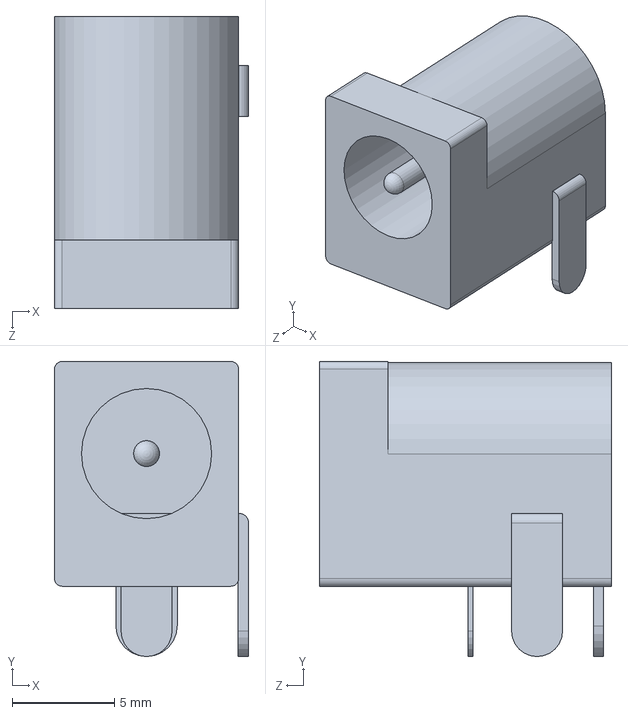
[picture p86: CAD file, 2024-03-14]
PCR_CAD/Electronics/Arduino Uno/RAPC732.sldprt
9.47 x 14.4 x 14.2 mm
