MJ2021/PCR-Machine-Construction/PCR_CAD/Heating/Kapton Heater.SLDPRT

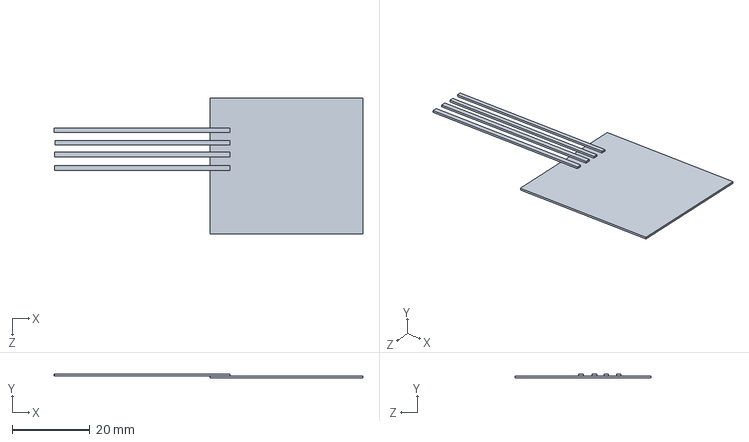
[picture p87: CAD file, 2024-03-14]
PCR_CAD/Heating/Kapton Heater.SLDPRT
79.7 x 1.00 x 35.0 mm
