MJ2021/PCR-Machine-Construction/PCR_CAD/Misc/USB cord.SLDPRT

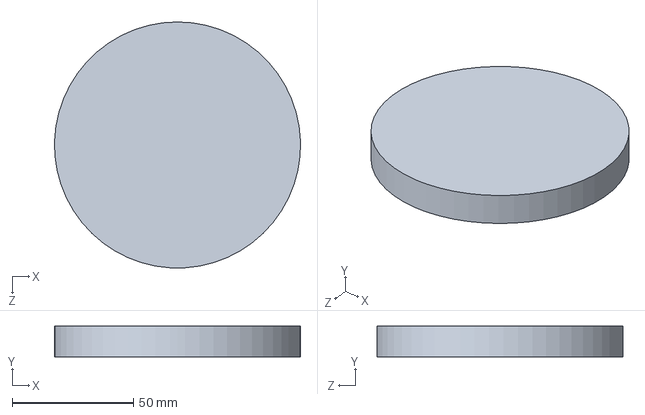
[picture p88: CAD file, 2024-03-14]
PCR_CAD/Misc/USB cord.SLDPRT
101.6 x 12.7 x 101.6 mm
