MJ2021/PCR-Machine-Construction/PCR_CAD/Construction/rubber_foot_hammond_1421T5CL.SLDPRT

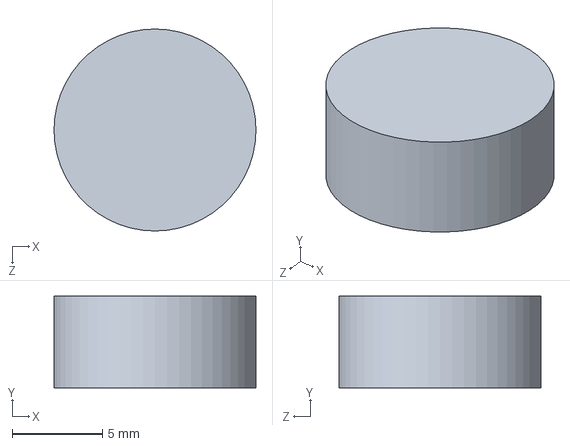
[picture p89: CAD file, 2024-03-14]
PCR_CAD/Construction/rubber_foot_hammond_1421T5CL.SLDPRT
11.2 x 5.08 x 11.2 mm
