MJ2021/PCR-Machine-Construction/PCR_CAD/Heating/Flat aluminum block adapter plate.SLDPRT

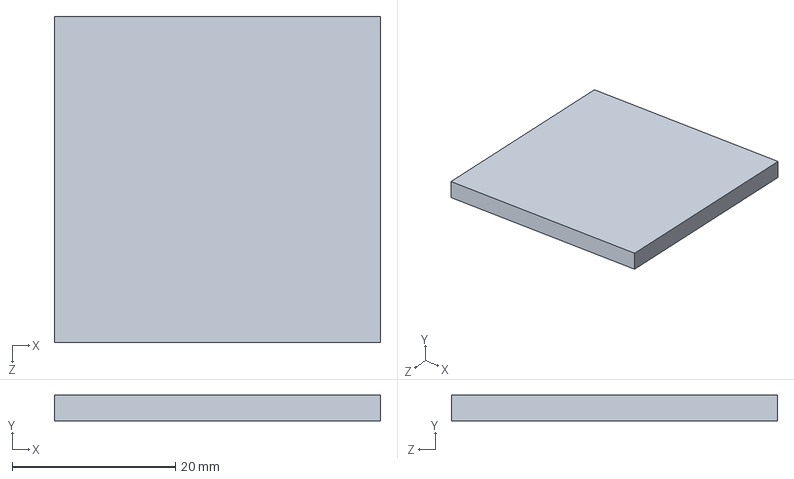
[picture p90: CAD file, 2024-03-14]
PCR_CAD/Heating/Flat aluminum block adapter plate.SLDPRT
40.0 x 3.17 x 40.0 mm
