MJ2021/PCR-Machine-Construction/PCR_CAD/Construction/3-16in-num6-spacer-94639A300.SLDPRT

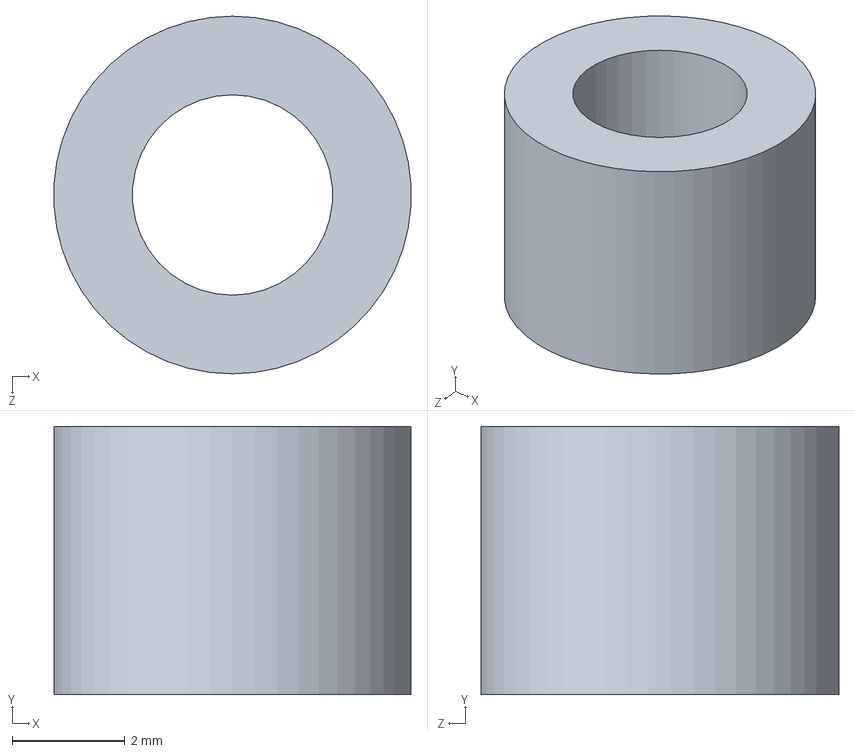
[picture p91: CAD file, 2024-03-14]
PCR_CAD/Construction/3-16in-num6-spacer-94639A300.SLDPRT
6.34 x 4.76 x 6.35 mm
