MJ2021/PCR-Machine-Construction/PCR_CAD/Lid/New hinged lid/Plate.SLDPRT

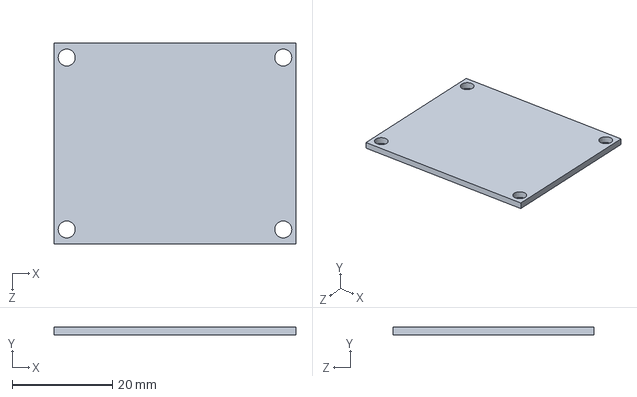
[picture p92: CAD file, 2024-03-14]
PCR_CAD/Lid/New hinged lid/Plate.SLDPRT
48.3 x 1.59 x 40.0 mm
