MJ2021/PCR-Machine-Construction/PCR_CAD/Misc/Lid_front.SLDPRT

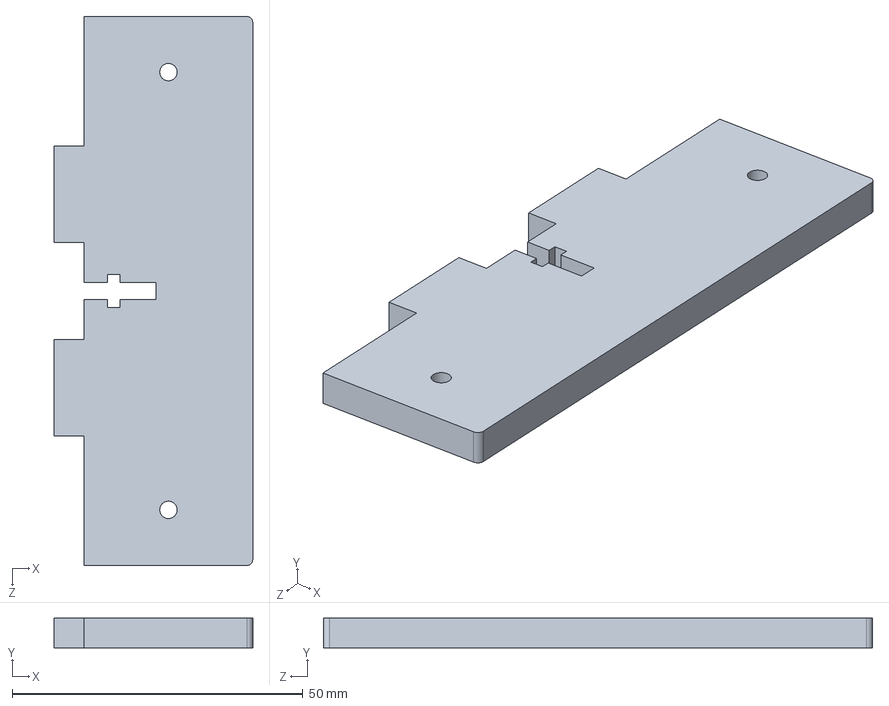
[picture p93: CAD file, 2024-03-14]
PCR_CAD/Misc/Lid_front.SLDPRT
34.1 x 5.13 x 94.4 mm
