MJ2021/PCR-Machine-Construction/PCR_CAD/Heating/1-16in-insulation.SLDPRT

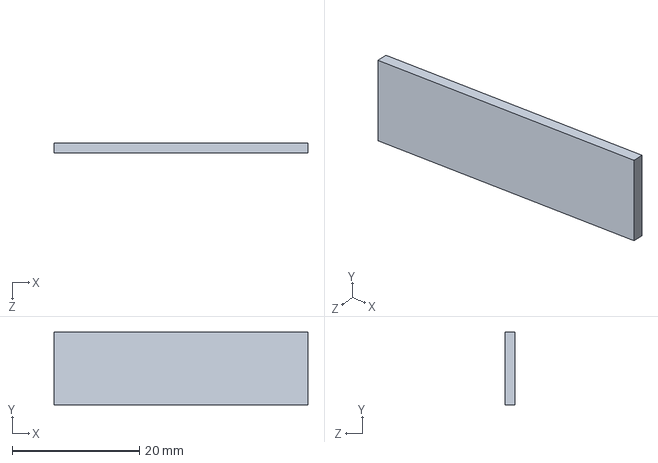
[picture p94: CAD file, 2024-03-14]
PCR_CAD/Heating/1-16in-insulation.SLDPRT
40.0 x 11.4 x 1.59 mm
