MJ2021/PCR-Machine-Construction/PCR_CAD/Lid/New hinged lid/1-8 in spacer.SLDPRT

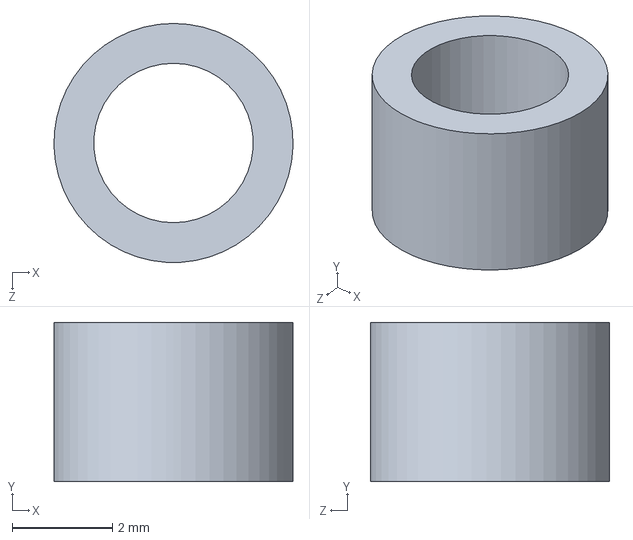
[picture p95: CAD file, 2024-03-14]
PCR_CAD/Lid/New hinged lid/1-8 in spacer.SLDPRT
4.76 x 3.17 x 4.76 mm
