MJ2021/PCR-Machine-Construction/PCR_CAD/Heating/Mounting plate.SLDPRT

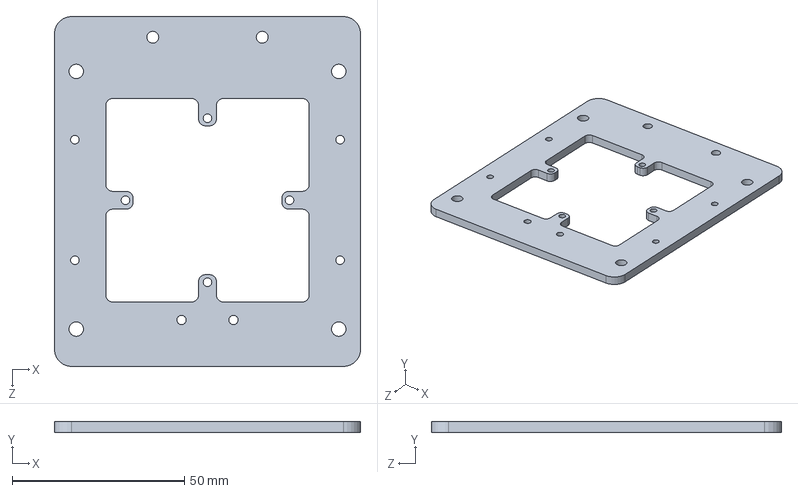
[picture p96: CAD file, 2024-03-14]
PCR_CAD/Heating/Mounting plate.SLDPRT
88.9 x 3.17 x 101.6 mm
