MJ2021/PCR-Machine-Construction/PCR_CAD/Misc/Latch bracket.SLDPRT

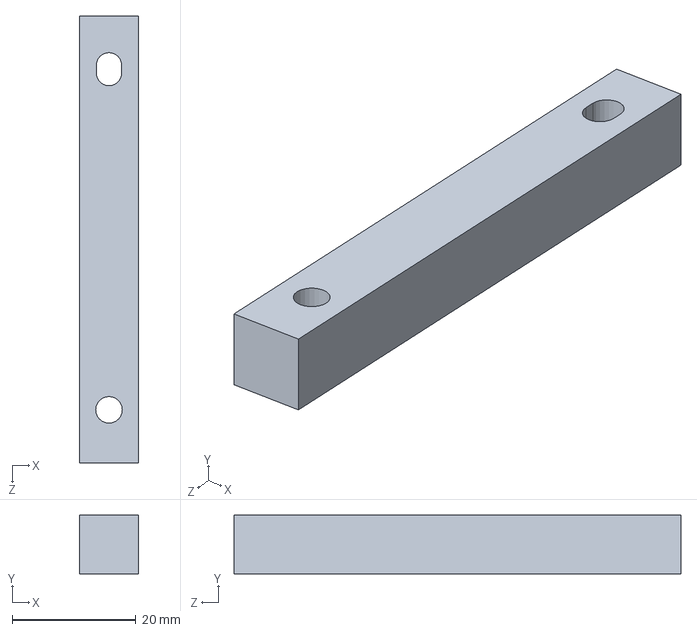
[picture p97: CAD file, 2024-03-14]
PCR_CAD/Misc/Latch bracket.SLDPRT
9.52 x 9.53 x 72.4 mm
