MJ2021/PCR-Machine-Construction/PCR_CAD/Heating/ATX power supply.SLDPRT

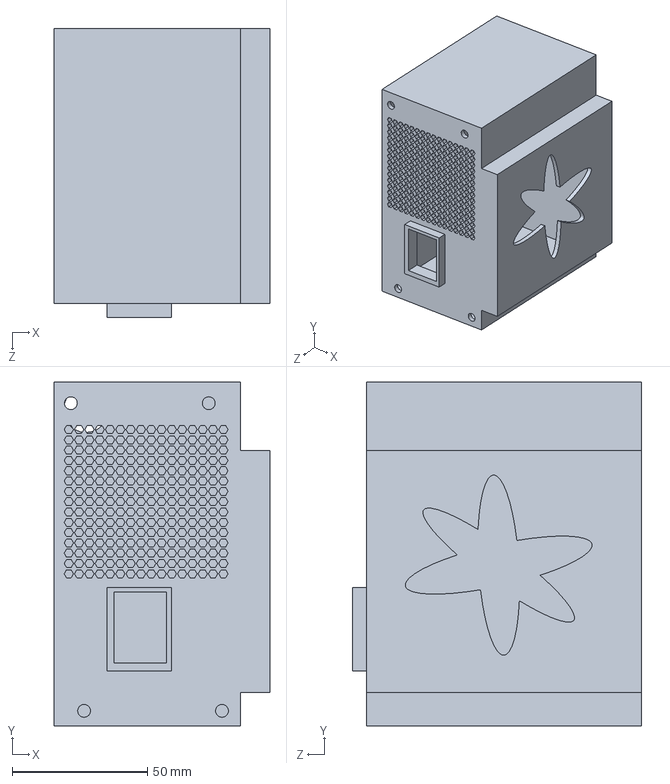
[picture p98: CAD file, 2024-03-14]
PCR_CAD/Heating/ATX power supply.SLDPRT
79.8 x 127.2 x 106.8 mm
