MJ2021/PCR-Machine-Construction/PCR_CAD/Lid/New hinged lid/Hinge.SLDPRT

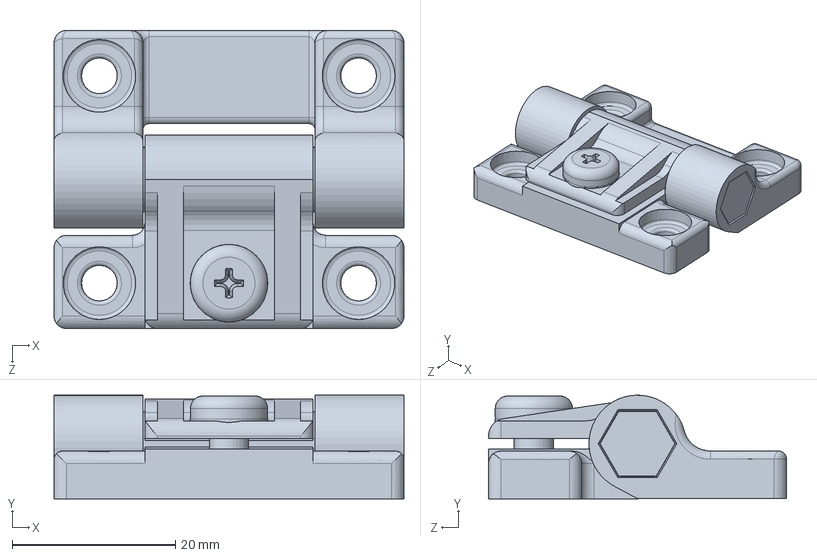
[picture p99: CAD file, 2024-03-14]
PCR_CAD/Lid/New hinged lid/Hinge.SLDPRT
42.9 x 12.7 x 36.5 mm
