MJ2021/PCR-Machine-Construction/PCR_CAD/Misc/derivced_aluminum_mounting_plate.SLDPRT

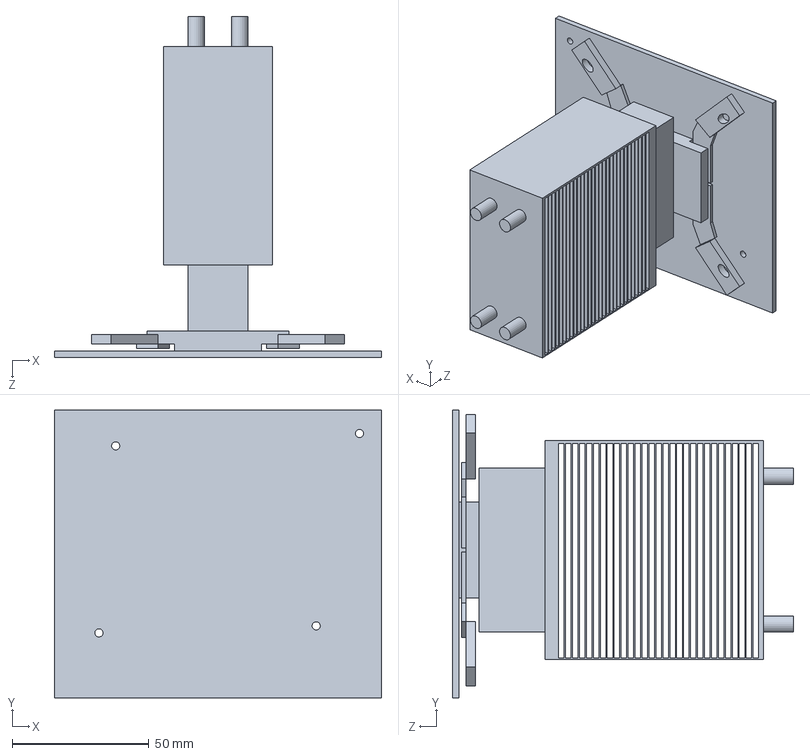
[picture p100: CAD file, 2024-03-14]
PCR_CAD/Misc/derivced_aluminum_mounting_plate.SLDPRT
119.6 x 105.2 x 124.8 mm
