MJ2021/PCR-Machine-Construction/PCR_CAD/Heating/Kapton heater insulation.SLDPRT

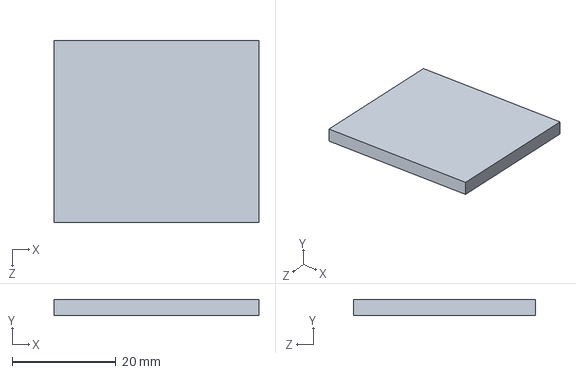
[picture p101: CAD file, 2024-03-14]
PCR_CAD/Heating/Kapton heater insulation.SLDPRT
39.5 x 3.17 x 35.0 mm
