MJ2021/PCR-Machine-Construction/PCR_CAD/Lid/New hinged lid/Hinge bracket.SLDPRT

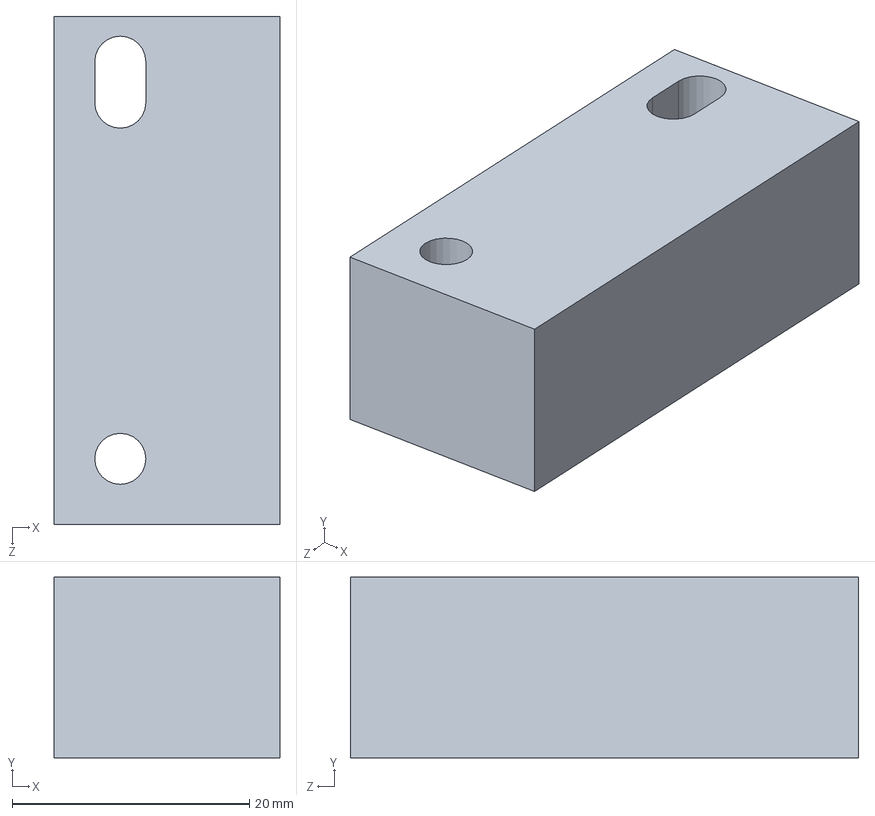
[picture p102: CAD file, 2024-03-14]
PCR_CAD/Lid/New hinged lid/Hinge bracket.SLDPRT
19.0 x 15.2 x 42.9 mm
