MJ2021/PCR-Machine-Construction/PCR_CAD/Misc/Heated plate bracket.SLDPRT

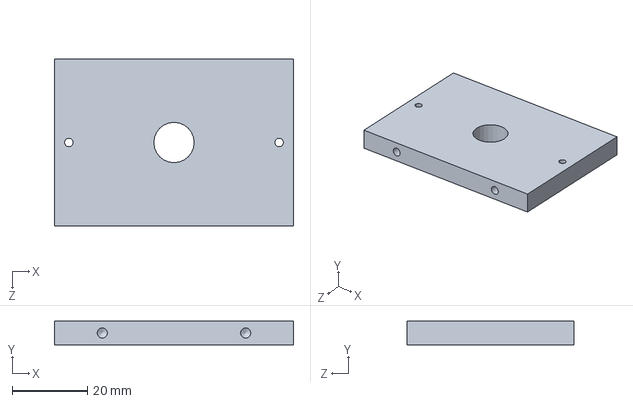
[picture p103: CAD file, 2024-03-14]
PCR_CAD/Misc/Heated plate bracket.SLDPRT
63.5 x 6.35 x 44.5 mm
