MJ2021/PCR-Machine-Construction/PCR_CAD/Heating/Rsenda ATX.SLDPRT

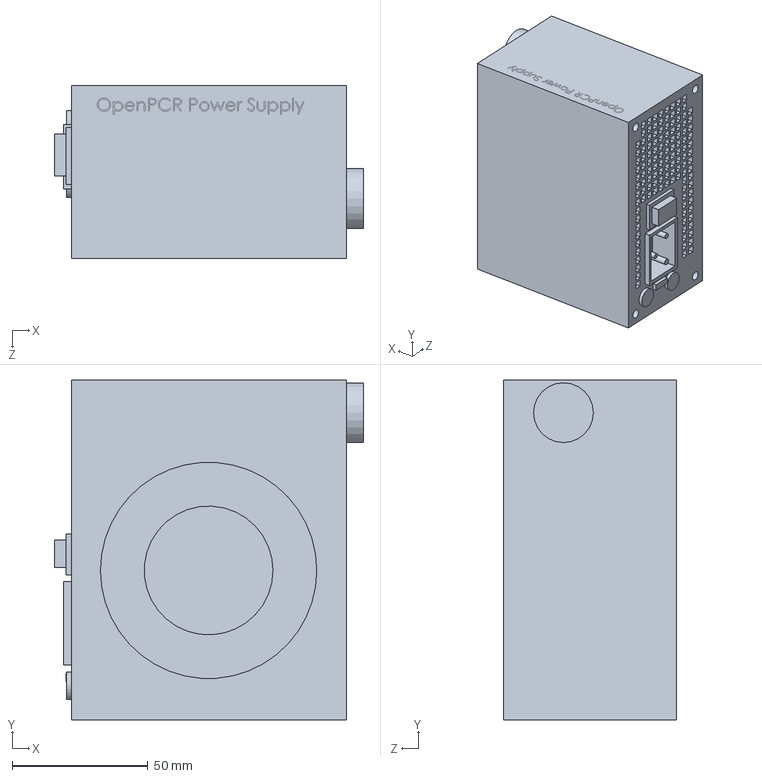
[picture p104: CAD file, 2024-03-14]
PCR_CAD/Heating/Rsenda ATX.SLDPRT
113.7 x 125.0 x 63.5 mm
