MJ2021/PCR-Machine-Construction/PCR_CAD/Construction/M5-mounting-phil-92005A320.SLDPRT

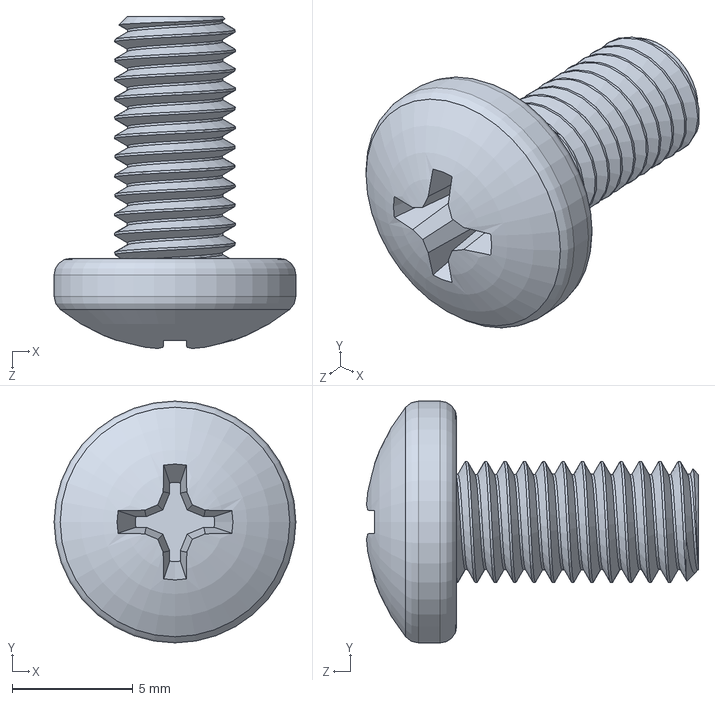
[picture p105: CAD file, 2024-03-14]
PCR_CAD/Construction/M5-mounting-phil-92005A320.SLDPRT
10.0 x 10.0 x 13.7 mm
