MJ2021/PCR-Machine-Construction/PCR_CAD/Misc/Back plate.SLDPRT

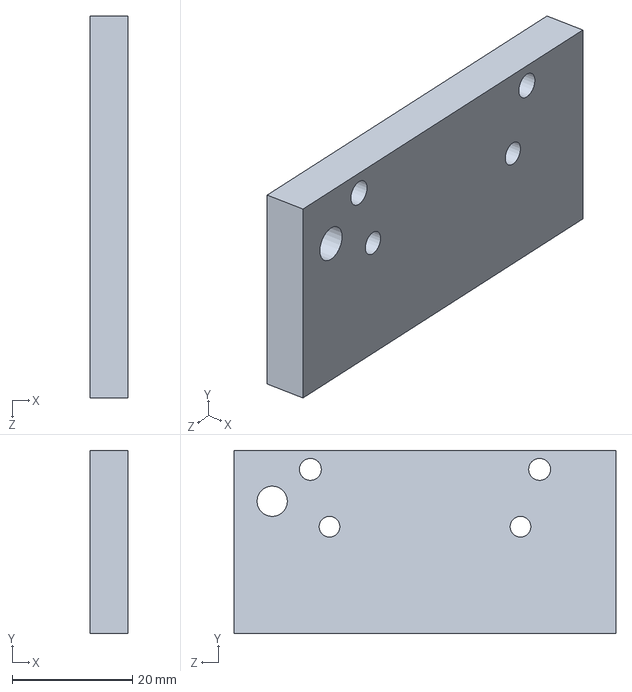
[picture p107: CAD file, 2024-03-14]
PCR_CAD/Misc/Back plate.SLDPRT
6.35 x 30.5 x 63.5 mm
