MJ2021/PCR-Machine-Construction/PCR_CAD/Misc/Lid_top.SLDPRT

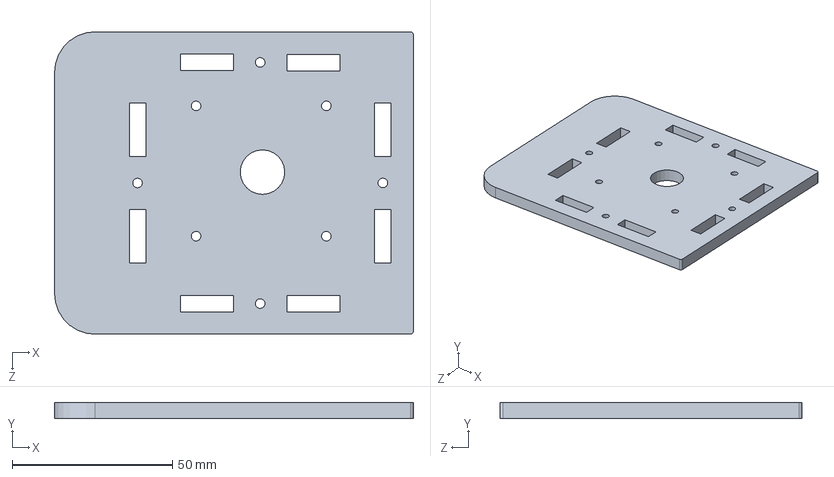
[picture p108: CAD file, 2024-03-14]
PCR_CAD/Misc/Lid_top.SLDPRT
112.0 x 5.13 x 94.4 mm
