MJ2021/PCR-Machine-Construction/PCR_CAD/Construction/Unthreaded_round_spacer_93657A145.SLDPRT

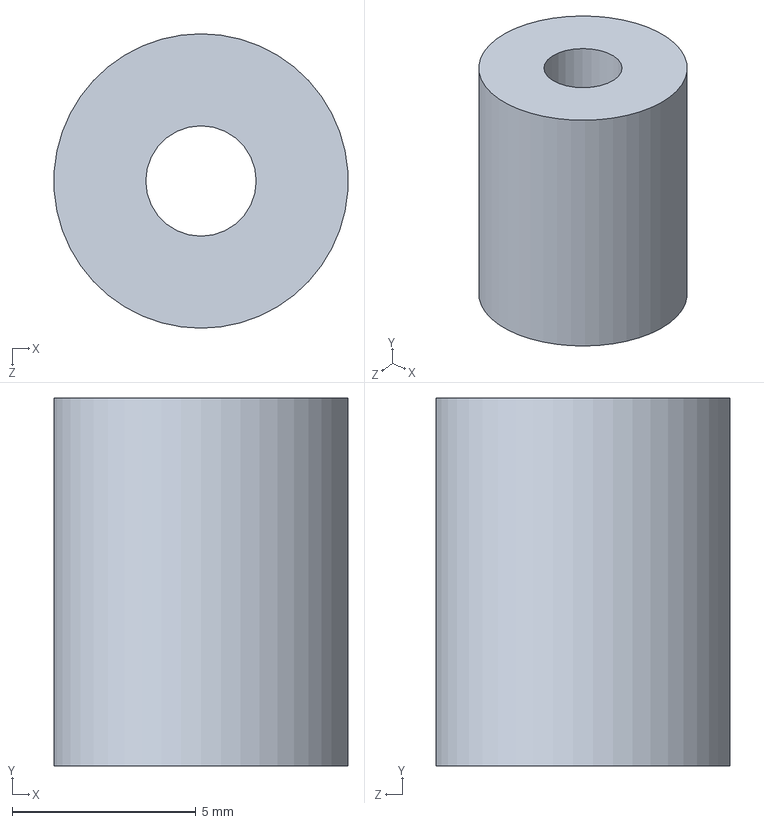
[picture p109: CAD file, 2024-03-14]
PCR_CAD/Construction/Unthreaded_round_spacer_93657A145.SLDPRT
7.98 x 10.0 x 8.00 mm
