MJ2021/PCR-Machine-Construction/PCR_CAD/Misc/Lid_side.SLDPRT

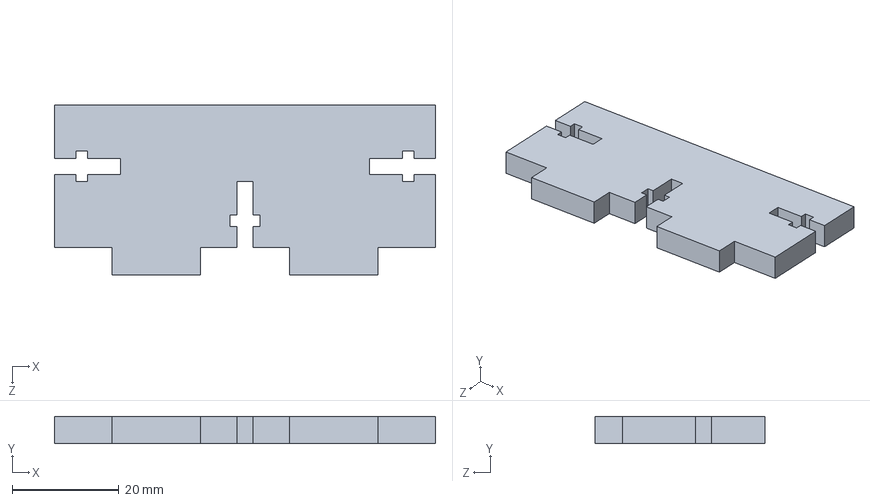
[picture p110: CAD file, 2024-03-14]
PCR_CAD/Misc/Lid_side.SLDPRT
71.4 x 5.13 x 31.9 mm
