MJ2021/PCR-Machine-Construction/PCR_CAD/Misc/Board with mounting holes.SLDPRT

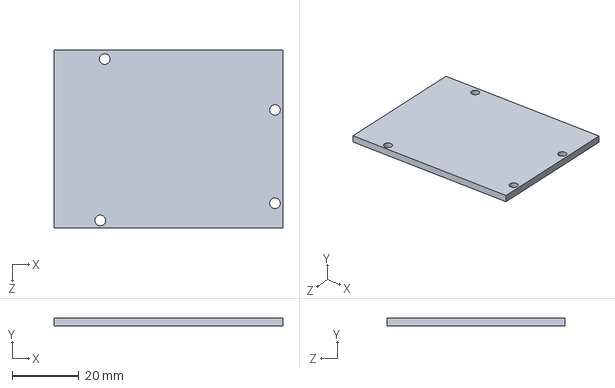
[picture p111: CAD file, 2024-03-14]
PCR_CAD/Misc/Board with mounting holes.SLDPRT
68.6 x 2.54 x 53.3 mm
