MJ2021/PCR-Machine-Construction/PCR_CAD/Misc/lcd ribbon.SLDPRT

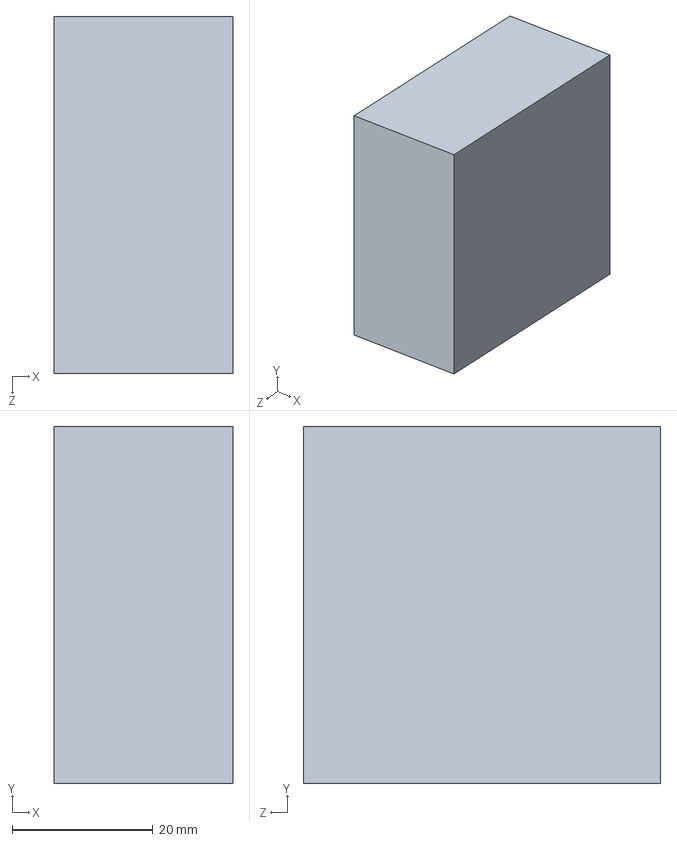
[picture p112: CAD file, 2024-03-14]
PCR_CAD/Misc/lcd ribbon.SLDPRT
25.4 x 50.8 x 50.8 mm
