MJ2021/PCR-Machine-Construction/PCR_CAD/Construction/3-8in-6-32-nylon-94611A146.SLDPRT

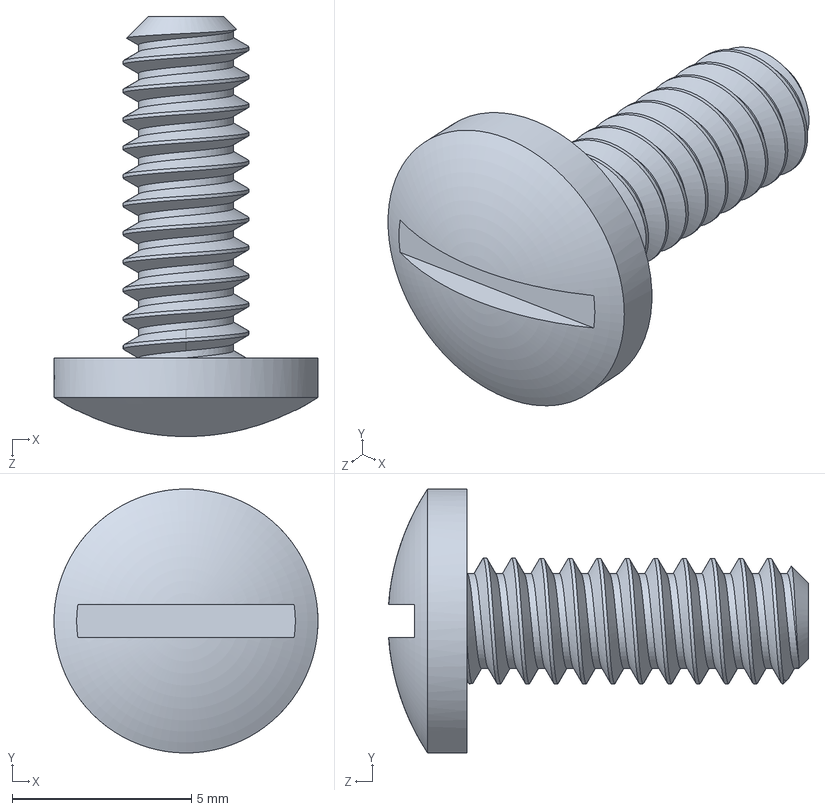
[picture p113: CAD file, 2024-03-14]
PCR_CAD/Construction/3-8in-6-32-nylon-94611A146.SLDPRT
7.37 x 7.37 x 11.7 mm
