MJ2021/PCR-Machine-Construction/PCR_CAD/Misc/Wooden Lid.SLDPRT

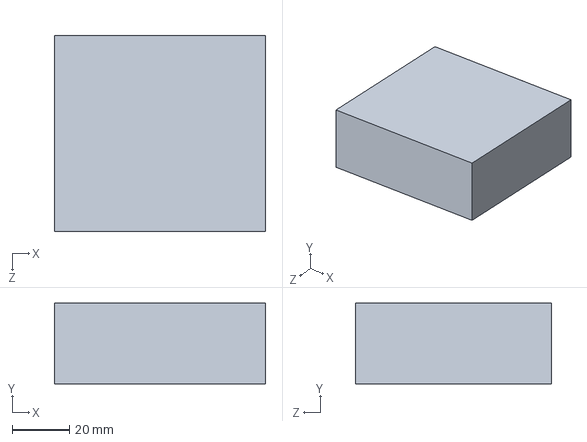
[picture p114: CAD file, 2024-03-14]
PCR_CAD/Misc/Wooden Lid.SLDPRT
73.7 x 28.2 x 68.6 mm
