MJ2021/PCR-Machine-Construction/PCR_CAD/Misc/heat sink.SLDPRT

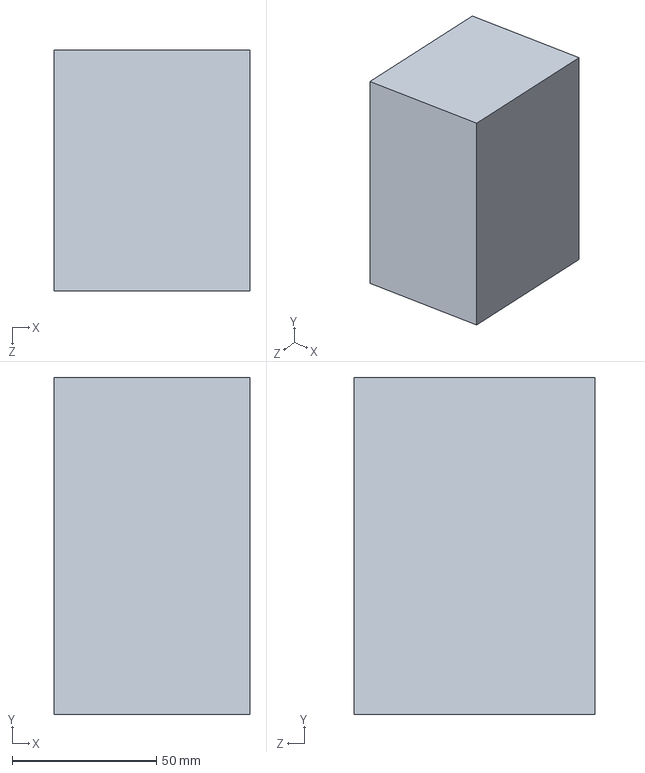
[picture p115: CAD file, 2024-03-14]
PCR_CAD/Misc/heat sink.SLDPRT
68.0 x 117.0 x 83.5 mm
