MJ2021/PCR-Machine-Construction/PCR_CAD/Construction/1-8in-bronze-sleeve-9368T96.SLDPRT

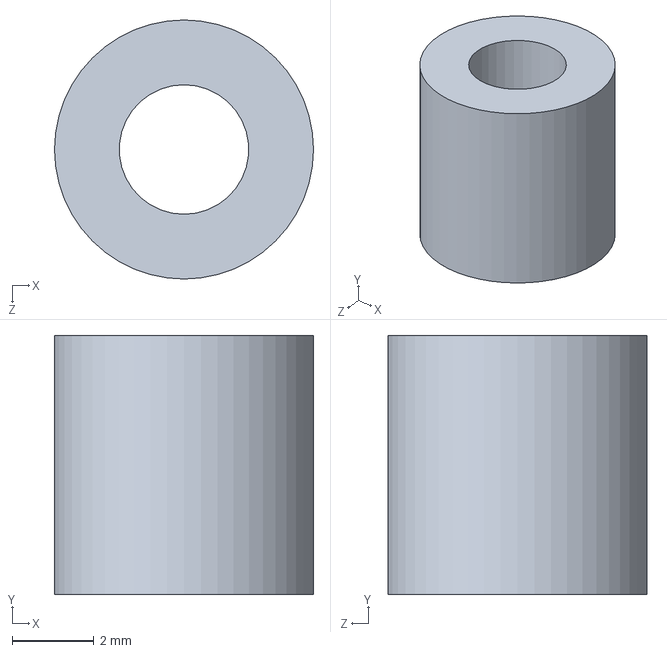
[picture p116: CAD file, 2024-03-14]
PCR_CAD/Construction/1-8in-bronze-sleeve-9368T96.SLDPRT
6.35 x 6.35 x 6.35 mm
