MJ2021/PCR-Machine-Construction/PCR_CAD/Misc/Flat aluminum mounting plate.SLDPRT

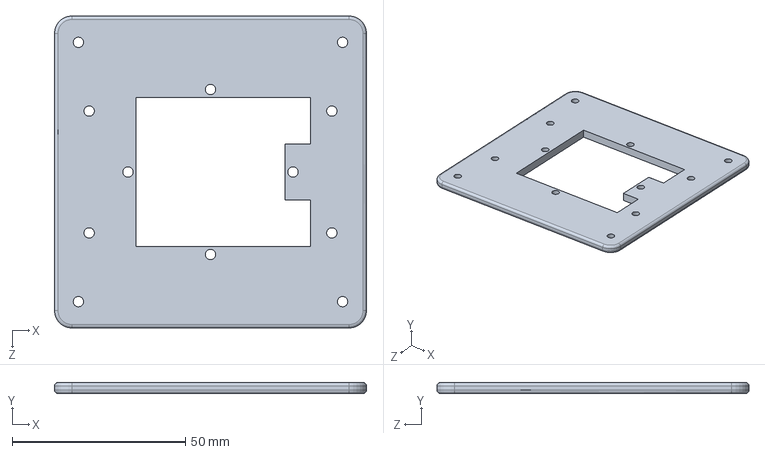
[picture p117: CAD file, 2024-03-14]
PCR_CAD/Misc/Flat aluminum mounting plate.SLDPRT
90.0 x 3.17 x 90.0 mm
