MJ2021/PCR-Machine-Construction/PCR_CAD/Misc/Top Plate Alum.SLDPRT

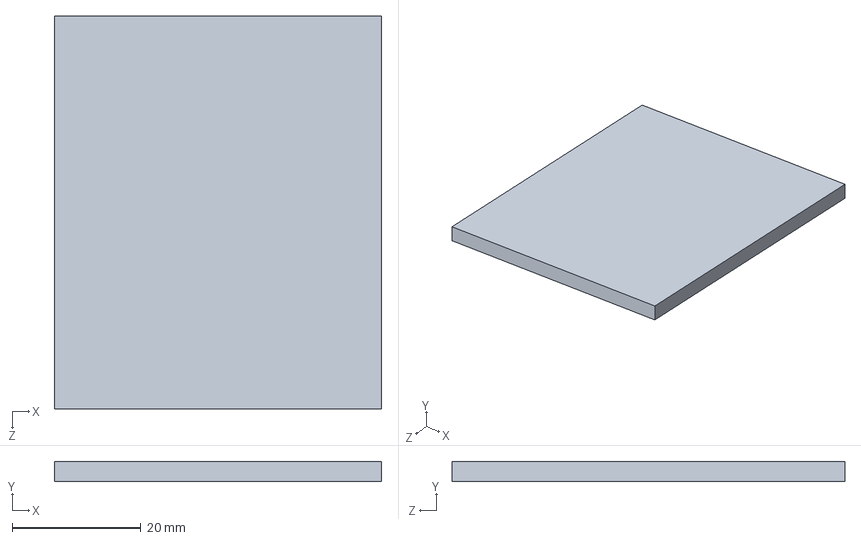
[picture p118: CAD file, 2024-03-14]
PCR_CAD/Misc/Top Plate Alum.SLDPRT
50.8 x 3.17 x 61.0 mm
