MJ2021/PCR-Machine-Construction/PCR_CAD/Construction/1in-6-32-phlp-undercut-91099A228.SLDPRT

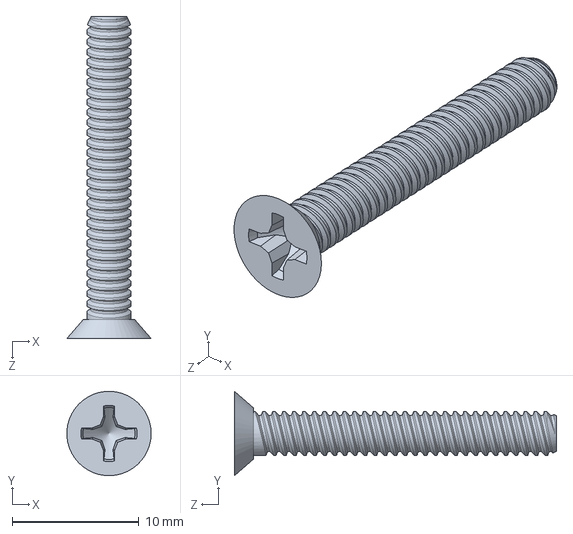
[picture p119: CAD file, 2024-03-14]
PCR_CAD/Construction/1in-6-32-phlp-undercut-91099A228.SLDPRT
6.65 x 6.65 x 25.4 mm
