MJ2021/PCR-Machine-Construction/PCR_CAD/Misc/Power cord.SLDPRT

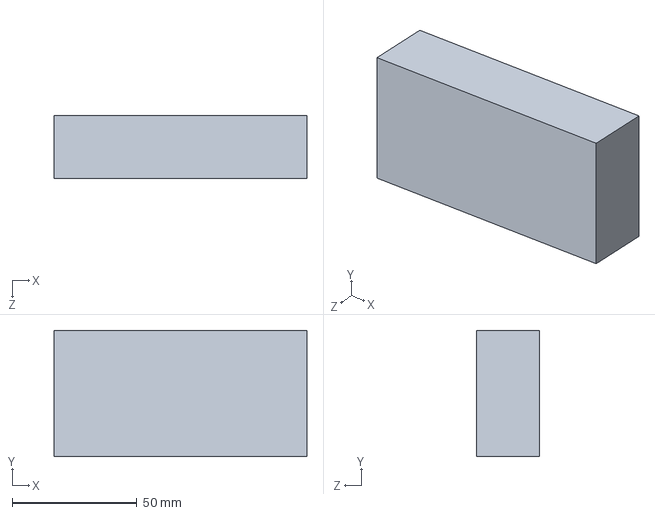
[picture p120: CAD file, 2024-03-14]
PCR_CAD/Misc/Power cord.SLDPRT
101.6 x 50.8 x 25.4 mm
