MJ2021/PCR-Machine-Construction/PCR_CAD/Construction/1-8in-unthreaded-spacer.SLDPRT

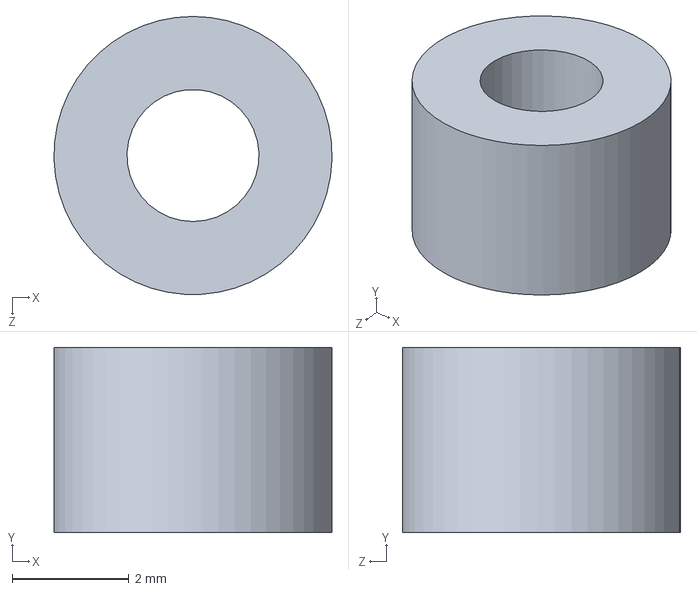
[picture p121: CAD file, 2024-03-14]
PCR_CAD/Construction/1-8in-unthreaded-spacer.SLDPRT
4.76 x 3.17 x 4.76 mm
