MJ2021/PCR-Machine-Construction/PCR_CAD/Construction/1in-8-32-phlp-91249A201.SLDPRT

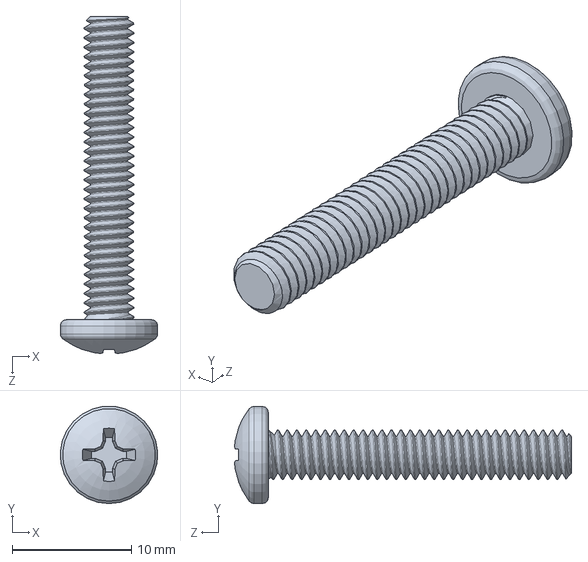
[picture p122: CAD file, 2024-03-14]
PCR_CAD/Construction/1in-8-32-phlp-91249A201.SLDPRT
8.16 x 8.15 x 28.2 mm
