MJ2021/PCR-Machine-Construction/PCR_CAD/Construction/4-40-standoff-93505A812.SLDPRT

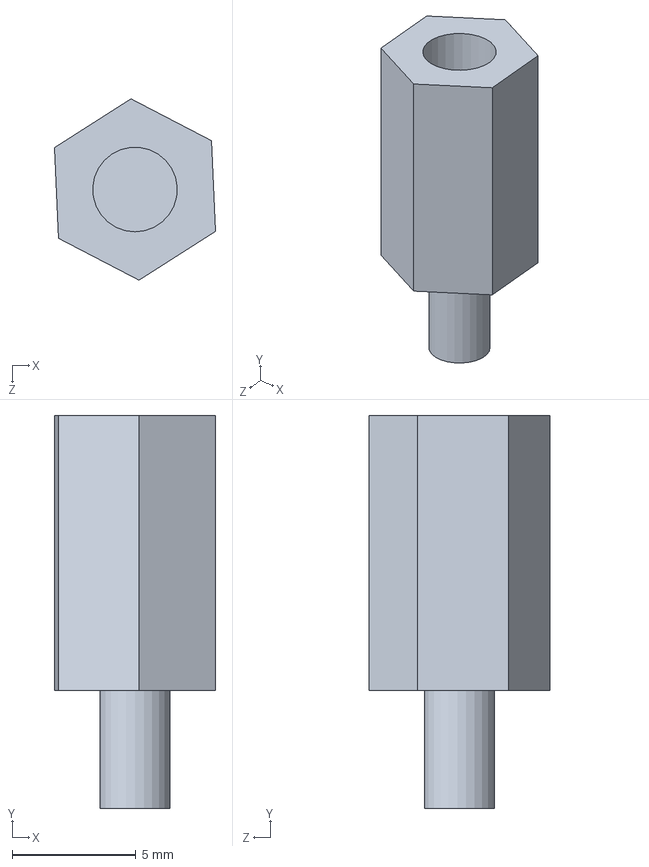
[picture p123: CAD file, 2024-03-14]
PCR_CAD/Construction/4-40-standoff-93505A812.SLDPRT
6.51 x 15.9 x 7.33 mm
