MJ2021/PCR-Machine-Construction/PCR_CAD/Construction/1in-8-32-hex-92196A199.SLDPRT

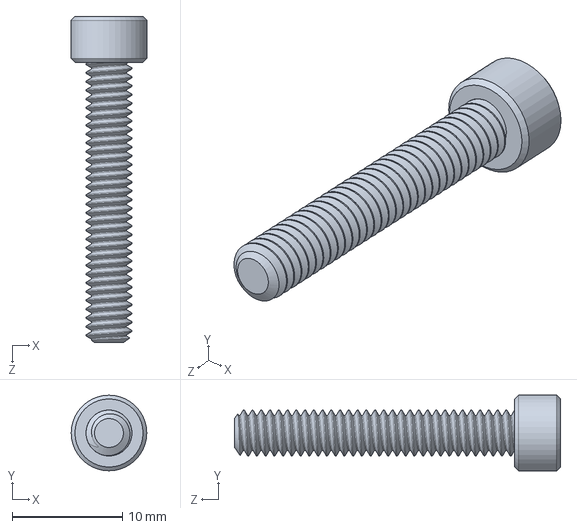
[picture p124: CAD file, 2024-03-14]
PCR_CAD/Construction/1in-8-32-hex-92196A199.SLDPRT
6.86 x 6.86 x 29.6 mm
