MJ2021/PCR-Machine-Construction/(list of files, cad)

Other CAD files:
PCR_CAD/Misc/SW3dPS-c3-810/SW3dPS-C3-810_C3_Grabber_Door_Catch_clf.sldasm
PCR_CAD/Misc/New hinged lid (original) 2.SLDASM
PCR_CAD/Misc/New hinged lid (original) 3.SLDASM
PCR_CAD/Misc/SW3dPS-c3-810/SW3dPS-C3-810_c3_housing_clf.sldprt
PCR_CAD/Misc/SW3dPS-c3-810/SW3dPS-C3-810_c3_rivet_clf.sldprt
PCR_CAD/Misc/Heat sink arms up.SLDPRT
PCR_CAD/Misc/SW3dPS-c3-810/SW3dPS-C3-810_c3_keeper_clf.sldprt
PCR_CAD/Heating/Heat sink 2.SLDPRT
PCR_CAD/Misc/SW3dPS-c3-810/SW3dPS-C3-810_C3_Pawl_Clf.sldprt
PCR_CAD/Lid/New hinged lid/spring_1986K300.SLDPRT
PCR_CAD/Construction/5-16in-phlps-black-91249A190.SLDPRT
PCR_CAD/Misc/Front plate.SLDPRT
PCR_CAD/Construction/3-4in-6-32-phlp-undercut-91099A224.SLDPRT
PCR_CAD/Construction/10_mm_screw.SLDPRT
PCR_CAD/Construction/4-40-nylon-1in-screw-97263A115.SLDPRT
PCR_CAD/Construction/4-40-nylon-nut-94900A005.SLDPRT
PCR_CAD/Construction/5-16in-8-32-hex-screw92196A191.SLDPRT
PCR_CAD/Construction/5-8in-spacer-#4-screw.SLDPRT
PCR_CAD/Construction/6-32-1-4in-screw-90275A144.SLDPRT
PCR_CAD/Construction/6-32-7-8in-screw-90275A152.SLDPRT
PCR_CAD/Construction/8_32_SS_nut_91841A009.SLDPRT
PCR_CAD/Construction/M3 Nut.SLDPRT
PCR_CAD/Construction/M3-washer-95610A130.SLDPRT
PCR_CAD/Construction/M3_10mm_SS_91292A113.SLDPRT
PCR_CAD/Construction/M3_16mm_SS_screw_black_91290A120.SLDPRT
PCR_CAD/Construction/M3_20mm_S_screw_91290A123.SLDPRT
PCR_CAD/Construction/M3_5mm_SS_screw_92095A177.SLDPRT
PCR_CAD/Construction/M3_6mm_SS_screw_92095A179.SLDPRT
PCR_CAD/Construction/M3_8mm_SS_screw_91292A112.SLDPRT
PCR_CAD/Construction/M3_8mm_SS_screw_92095A181.SLDPRT
PCR_CAD/Construction/M5_10mm_S_91239A224.SLDPRT
PCR_CAD/Construction/M5_10mm_S_91460A224.SLDPRT
PCR_CAD/Construction/M5_12mm_S_91239A228.SLDPRT
PCR_CAD/Construction/M5_14mm_S_91239A230.SLDPRT
PCR_CAD/Construction/M5_S_heavy_nut_990725A030.SLDPRT
PCR_CAD/Construction/M5_S_nut_90592A012.SLDPRT
PCR_CAD/Construction/M6_hex_nut_93510A120.SLDPRT
PCR_CAD/Heating/Main Heating Block (2).SLDPRT
PCR_CAD/Heating/Nylon Washer.SLDPRT
PCR_CAD/Lid/New hinged lid/1.4inbolt.SLDPRT
PCR_CAD/Lid/New hinged lid/3-4 1-2-20 bolt.SLDPRT
PCR_CAD/Lid/New hinged lid/3-4in-shoulder screw 3-16 dia.SLDPRT
PCR_CAD/Lid/New hinged lid/Bolt with knob.SLDPRT
PCR_CAD/Misc/1-2 in shoulder screw 1-8 dia.SLDPRT
PCR_CAD/Misc/3-4 in bolt.SLDPRT
PCR_CAD/Misc/Archive/LCD Adafruit.SLDPRT
PCR_CAD/Misc/CK tools prototype A/1-2 in shoulder screw 1-8 dia.SLDPRT
PCR_CAD/Misc/CK tools prototype A/Lid Part A.SLDDRW
PCR_CAD/Misc/CK tools prototype A/Plate Part B.SLDDRW
PCR_CAD/Misc/Drawings/Adapter plate.SLDDRW
PCR_CAD/Misc/Drawings/Lid Plate.SLDDRW
PCR_CAD/Misc/Drawings/Main Heating Block Drawing.SLDDRW
PCR_CAD/Misc/Shoulder screw2.SLDPRT
PCR_CAD/Misc/archived/Main Heating Block.SLDPRT
PCR_CAD/Misc/deleteme.SLDPRT
