MJ2021/PCR-Machine-Construction/Report_3/ourpcbboth.pdf

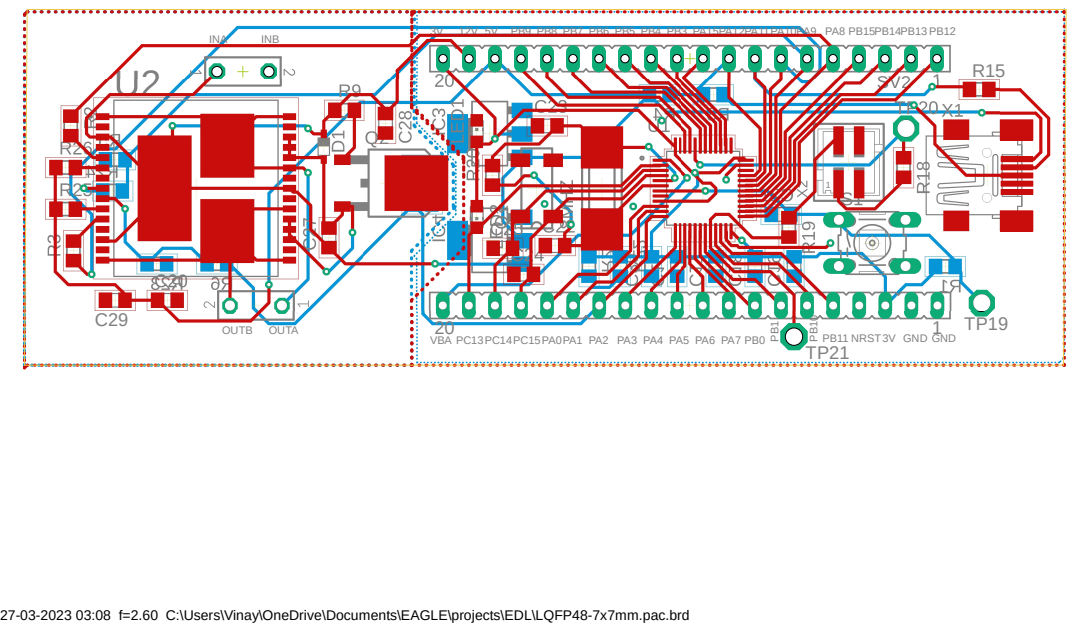
[picture p125: page 1]
VBA PC13PC14PC15PA0PA1 PA2 PA3 PA4 PA5 PA6 PA7 PB0 PB¹; PB¹⁰ PB11 NRST3V GND GND; OUTB; OUTA; INA; INB

27-03-2023 03:08 f=2.60 C:\Users\Vinay\OneDrive\Documents\EAGLE\projects\EDL\LQFP48-7x7mm.pac.brd
