MJ2021/PCR-Machine-Construction/Report_3/ourpcbschematic.pdf

# R21 R22 R²³

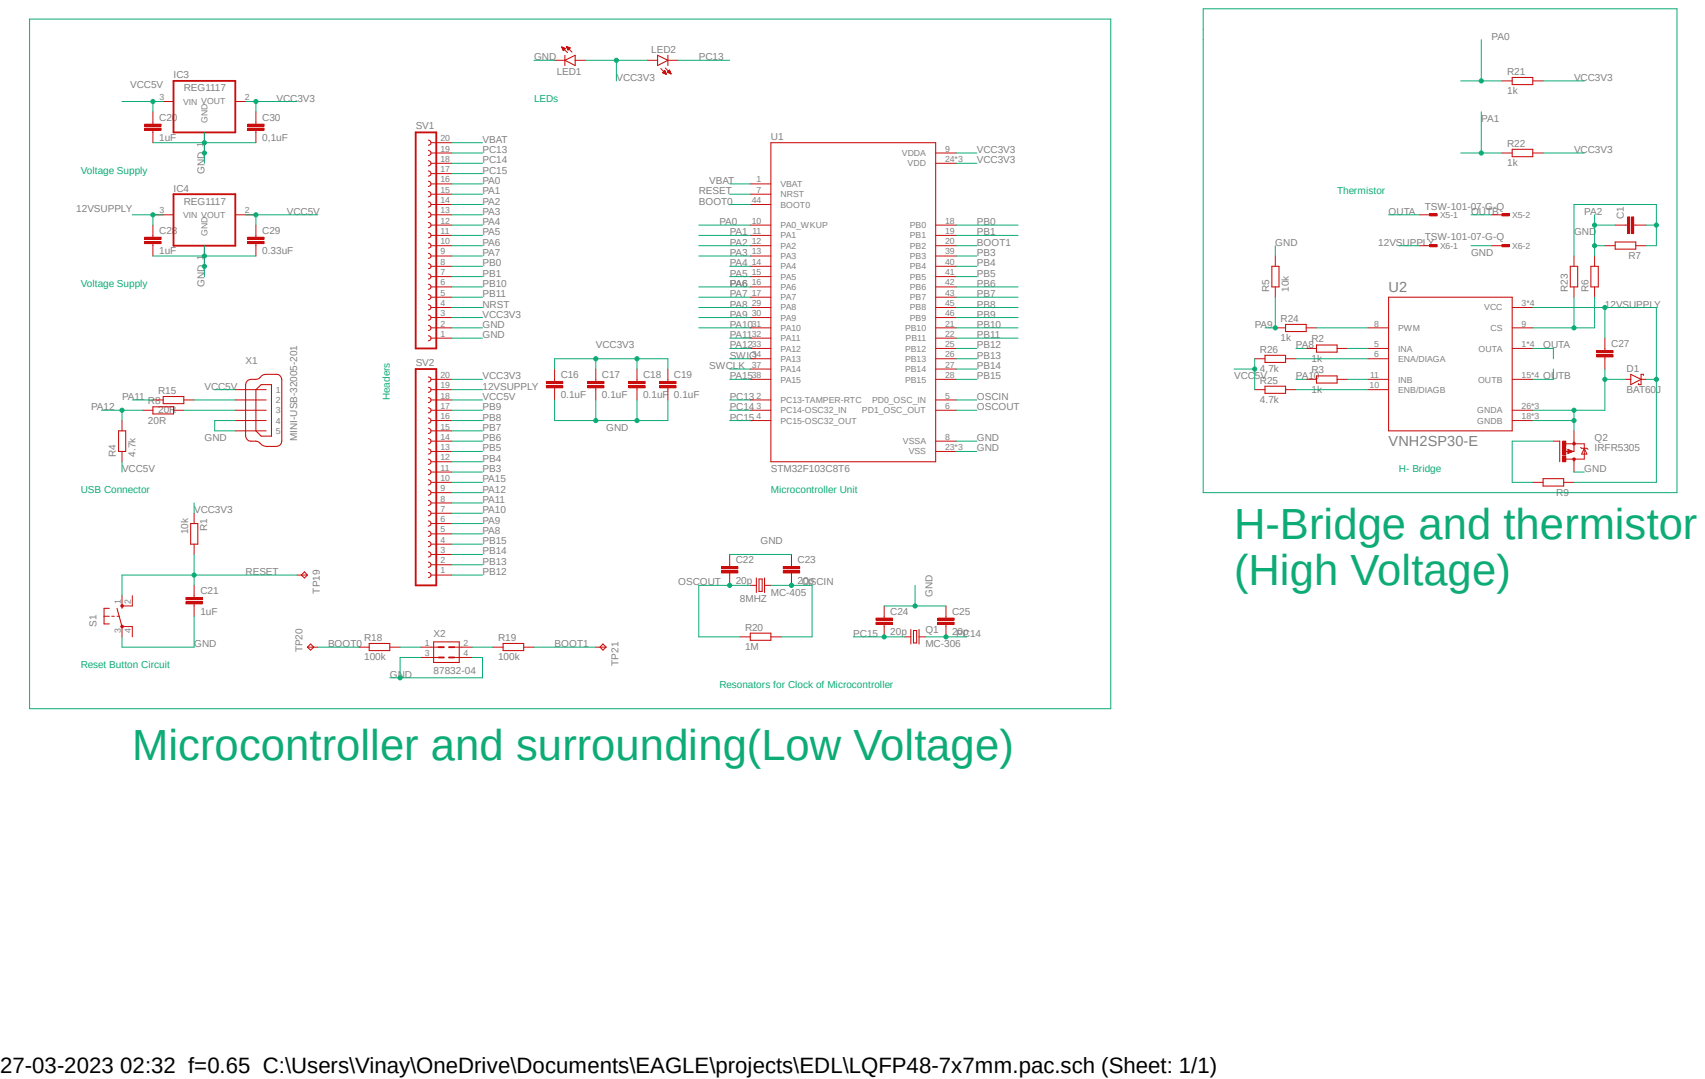
[picture p126: page 1]

Voltage Supply Voltage Supply USB Connector Reset Button Circuit
12VSUPPLY

Microcontroller and surrounding(Low Voltage)

27-03-2023 02:32 f=0.65 C:\Users\Vinay\OneDrive\Documents\EAGLE\projects\EDL\LQFP48-7x7mm.pac.sch (Sheet: 1/1)
