MJ2021/PCR-Machine-Construction/Report_3/ourpcbbottom.pdf

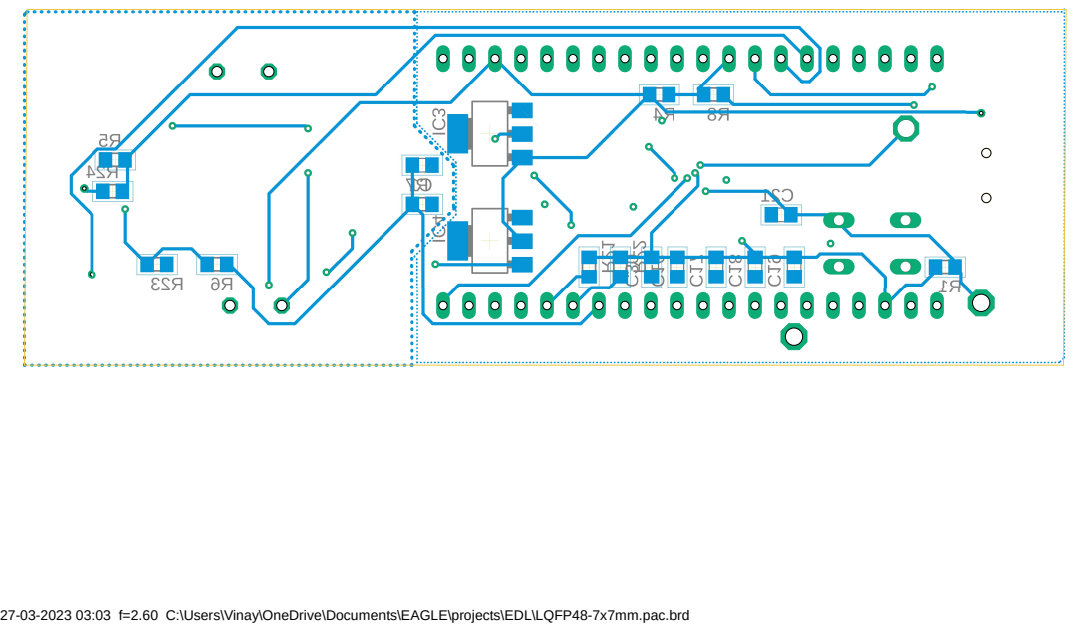
[picture p127: page 1]

27-03-2023 03:03 f=2.60 C:\Users\Vinay\OneDrive\Documents\EAGLE\projects\EDL\LQFP48-7x7mm.pac.brd
