MJ2021/PCR-Machine-Construction/Report_3/ourpcbbottomgplane.pdf

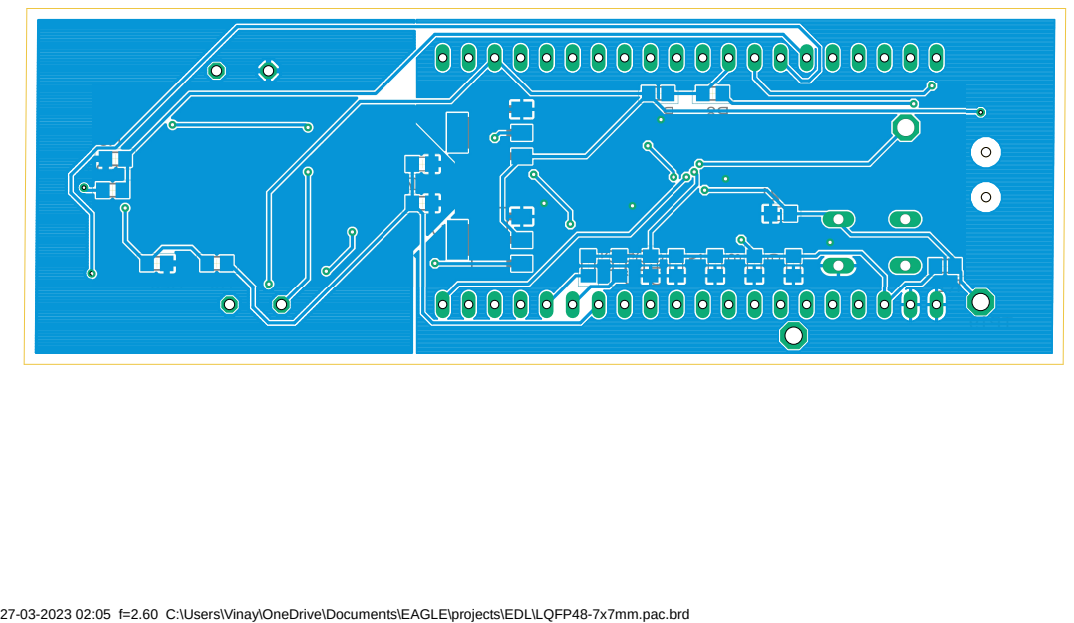
[picture p128: page 1]

27-03-2023 02:05 f=2.60 C:\Users\Vinay\OneDrive\Documents\EAGLE\projects\EDL\LQFP48-7x7mm.pac.brd
